geobenedict/Design-Files/CIRCUIT_DIAGRAM/PCB_FILES/RADIO_TRIANGULATION_BASE_STATION/RTK_PCB_Schematic.png

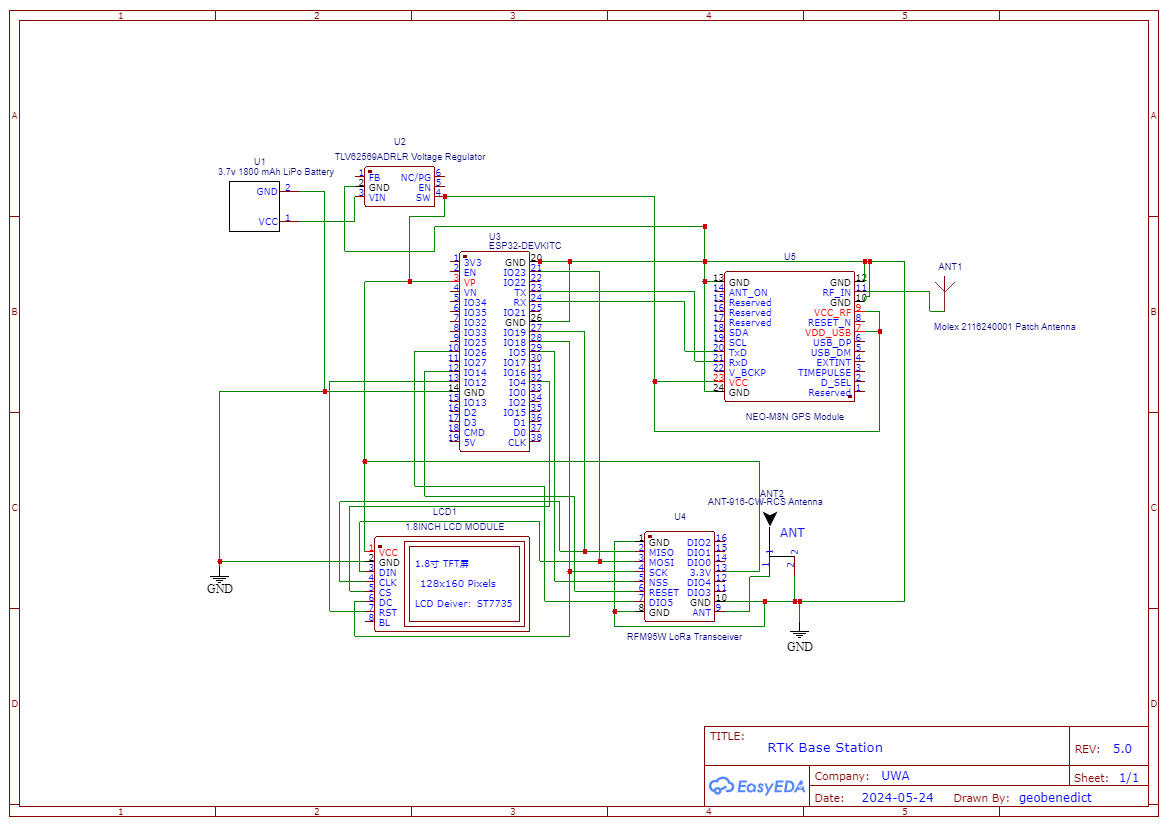
CIRCUIT_DIAGRAM/PCB_FILES/RADIO_TRIANGULATION_BASE_STATION/RTK_PCB_Schematic.png
