geobenedict/Design-Files/SYSTEM_DESIGN/Overall Design Architecture.jpg

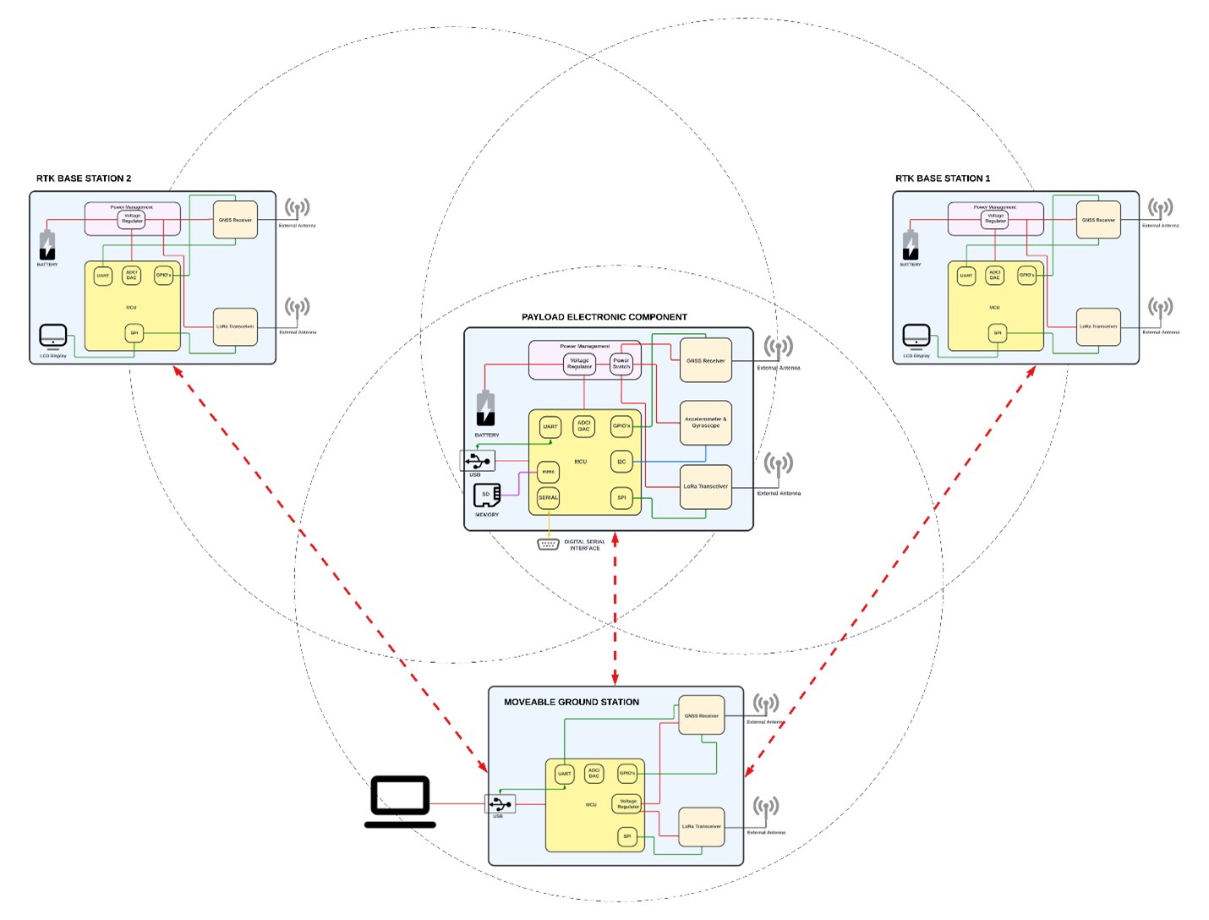
SYSTEM_DESIGN/Overall Design Architecture.jpg
