geobenedict/Design-Files/SYSTEM_DESIGN/Radio Triangulation Base Station Architecture.jpg

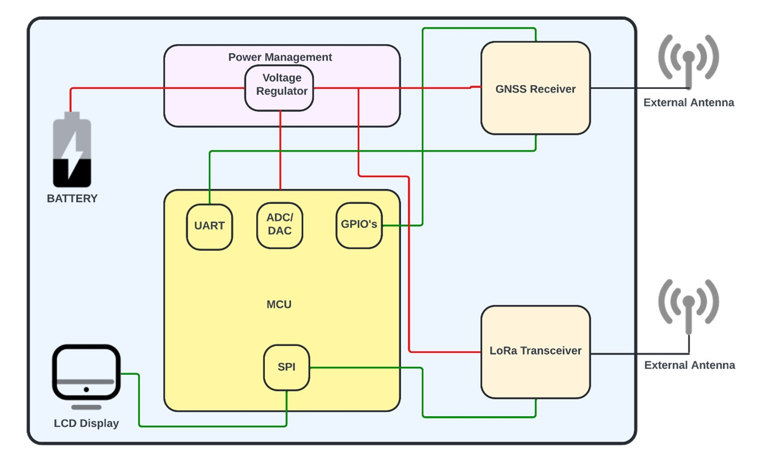
SYSTEM_DESIGN/Radio Triangulation Base Station Architecture.jpg
