geobenedict/Design-Files/SYSTEM_DESIGN/Receiving Bay Station Architecture.jpg

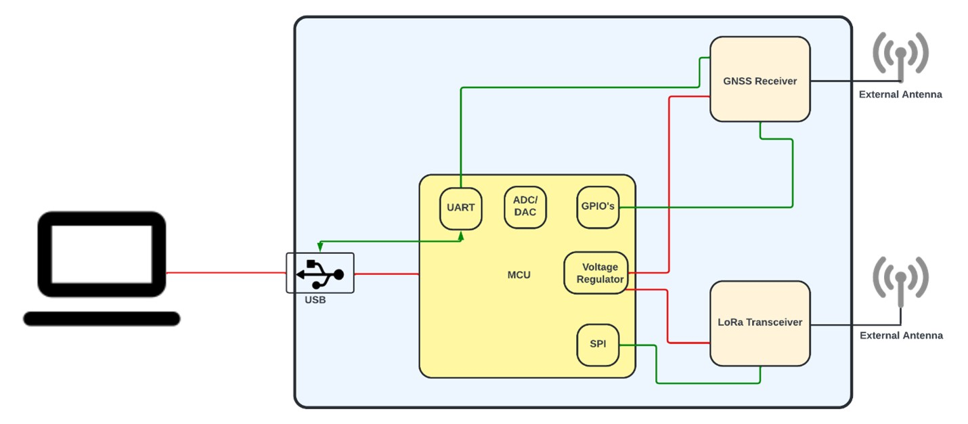
SYSTEM_DESIGN/Receiving Bay Station Architecture.jpg
