geobenedict/Design-Files/CIRCUIT_DIAGRAM/PCB_FILES/PAYLOAD_ELECTRIC_COMPONENT/DW_PEC_BOM_Weight_Power.xlsx

Sheet: BOM
Designator on Schematics | Description | Qty | Supplier | Supplier Unit Price (AUD) | Total Price
Components on the PCB
C1_SW2, C2_SW2, C_M2, C_S2, C_SW1 | CAP CER 0.1UF 50V X7R 0603 | 5 | Newark | 0.0303 | 0.1515
C _G1 | CAP CER 0.027UF 50V X7R 0805 | 1 | Arrow Electronics | 0.01636 | 0.01636
C_A1 | CAP CER 0.1UF 16V X7R 0402 | 1 | Newark | 0.00909 | 0.00909 |  | Power Consumption (mA)
C_M1 | Multilayer Ceramic Capacitors 22μF ±20% 10V X5R SMD 0805 | 1 | Newark | 0.18029 | 0.18029 |  | Component | ESP 32 WROOM 32 D | LoRa RFM95W | GPS NEO M8N | MPU 6050 | Voltage Regulator | Passive Components | Antenna
C_S1 | CAP CER 4.7UF 6.3V X5R 0603 | 1 | Mouser | 0.1818 | 0.1818 | Modes | Active Mode | 95 ~ 240 mA
C_U1 | CAP CER 0.1UF 200V 10% X7R 1206 | 1 | Newark | 0.10302 | 0.10302 |  | Modem Sleep Mode | 2~4 mA @ 2MHz 20~25mA @ 80MHz 30~ 50mA @240MHz
C_V1 | CAP CER 4.7UF 10V X5R 0402 | 1 | Newark | 0.13938 | 0.13938 |  | Light Sleep Mode | ~0.8 mA
C_V2, C_V3, C_V4 | CAP CER 10UF 6.3V X5R 0402 | 3 | Mouser | 0.22725 | 0.68175 |  | Deep Sleep Mode | 10 -150 uA
D1, D2, D3 | TVS DIODE 6V 10.3V DO214AA | 3 | Newark | 0.14847 | 0.44541 |  | Transmit Mode |  | RFOP = +20 dBm ~ 120mA RFOP = +17 dBm ~ 87mA RFOP = +13 dBm ~ 29mA RFOP = + 7 dBm ~ 20mA
J1 | Male Header, Pitch 2 mm, 1 x 2 Position, Height 5.5 mm, -25 to 85 degC, RoHS, Tape and Reel | 1 | Digikey | 0.61 | 0.61 |  | Receive Mode |  | 10.3mA
J2 | Micro-USB B Receptacle, Right Angle, Bottom Mount, Surface Mount, with Solder Tabs, -30 to 85 degC, 5-Pin USB, RoHS, Tape and Reel | 1 | Arrow Electronics | 0.56055 | 0.56055 |  | Sleep Mode |  | 0.2 ~ 1uA
J3 | CONN MICRO-D PLUG 9POS R/A SLDR | 1 | Arrow Electronics | 17.61 | 17.61 |  | Idle Mode |  | 1.5mA - RC oscillator enabled
J4 | CONN MICRO SD CARD PUSH-PULL R/A | 1 | Newark | 1.77 | 1.77 |  | Icc Acquisition |  |  | 25mA
L_G1 | Wire Wound RF Inductor 27nH ±2% 440mA 0.21Ω 0603 (1608) | 1 | Mouser | 0.22725 | 0.22725 |  | Icc Tracking - Continous mode |  |  | 23mA
L_V1 | Fixed Inductors 2.2uH Shld 20% 5.5A 38.7mOhms AECQ2 | 1 | Mouser | 3.58 | 3.58 |  | Icc Tracking - Power saving mode |  |  | 12mA
Q1, Q2 | NPN TRANSISTOR 1.5A 40V SOT-23 R | 2 | Digikey | 0.43935 | 0.8787 |  | Gyroscope + Accelerometer+DMP |  |  |  | 3.9mA
R 2 | RES 100K OHM 1% 1/16W 0402 | 1 | Newark | 0.00606 | 0.00606 |  | Gyroscope + Accelerometer |  |  |  | 3.8mA
R_G1 | RES | 1 | Arrow Electronics | 0.00773 | 0.00773 |  | Gyroscope Only |  |  |  | 500uA
R_S1 | RES | 1 | Newark | 0.00455 | 0.00455
R_S2, R_S4 | RES Thick Film, 100Ω, 5%, 0.1W, 200ppm/°C, 0603 | 2 | Digikey | 0.1515 | 0.303
R_S3 | RES SMD 47K OHM 5% 1/10W 0603 | 1 | Newark | 0.00455 | 0.00455
R_S5 |  | 1 | Newark | 0.00455 | 0.00455
R_S6, R_SW2 | RES Thick Film, 10kΩ, 5%, 0.125W, 200ppm/°C, 0805 | 2 | Digikey | 0.1515 | 0.303
R_S7, R_S8 | Chip Resistor, 0 Ohm, Jumper, +/- 5%, 0.125 W, -55 to 155 degC, 0805 (2012 Metric), RoHS, Tape and Reel | 2 | Mouser | 0.02424 | 0.04848
R_SH1, R_SH2 |  | 2 | Newark | 0.00303 | 0.00606
R_V1 | RES Thick Film, 453kΩ, 1%, 0.063W, 100ppm/°C, 0402 | 1 | Mouser | 0.1515 | 0.1515
SW1, SW2 | SWITCH TACTILE SPST-NO 0.05A 24V | 2 | Digikey | 0.68175 | 1.3635
U1 | WIFI MODULE 32MBITS SPI FLASH | 1 | Digikey | 7.21 | 7.21
U2 | RX TXRX MODULE ISM < 1GHZ SMD | 1 | Digikey | 21.88 | 21.88
U3 | U-Blox M8 Concurrent Gnss Module, 3.6 V, -40 to 85 degC, 24-Pin SMD, RoHS, Tape and Reel | 1 | Mouser | 47.72 | 47.72
U4 | 3-Axis Gyroscope, Accelerometer and a Digital Motion Processor(TM) (DMP), 2.375 to 3.46 V, -40 to 85 degC, 24-Pin QFN, RoHS, Tape and Reel | 1 | Digikey | 13.2 | 13.2
U5 | IC REG BUCK ADJ 2A SOT23-5 | 1 | Arrow Electronics | 0.64539 | 0.64539
U6 | IC BRIDGE USB TO UART 28QFN | 1 | Digikey | 7.46 | 7.46
UFL1, UFL2 | Ultra Small Coaxial Connector, 6 GHz, -40 to 90 degC, 3-Pin SMD, RoHS, Bulk | 2 | Newark | 1.31 | 2.62
Other Misc & connectors
B1 | BATTERY 3.7V 2000mAH | 1 | Core Electronics | 17.55 | 17.55
W1 | UFL TO SMA CONNECTOR | 2 | DigiKey | 5.99 | 11.98
A1 | HELICAL ANTENNA | 2
 |  |  |  | Total | 159.61347

Sheet: Weight
Components | Quantity | Weight | Total Weight
Capacitors | 14 | 0.0048 | 0.0672
Diodes | 3 | 0.093 | 0.279
Micro Usb | 1 | 0.233 | 0.233
Micro D | 1 | 4.47 | 4.47
Micro sd card | 1 | 0.026 | 0.026
Micro sd module | 1 | 0.05 | 0.05
Inductors | 2 | 0.003 | 0.006
Resistors | 14 | 0.05 | 0.7
Transistors | 2 | 0.05 | 0.1
Switches | 2 | 0.25 | 0.5
ESP32 | 1 | 2.3 | 2.3
RFM95W | 1 | 5 | 5
NEO M8N | 1 | 1.6 | 1.6
MPU6050 | 1 | 0.13 | 0.13
TLB | 1 | 0.01 | 0.01
CP2102 | 1 | 0.05 | 0.05
UFL Connector | 2 | 0.0157 | 0.0314
 |  | Total Weight | 15.5526
Battery | 1 | 40 | 40
 |  | Total Weight | 55.5526
Antenna | 2 | 15 | 30
 |  | Total Weight | 85.5526

Sheet: Power Consumption
 | Power Consumption (mA)
 | Component | ESP 32 WROOM 32 D | LoRa RFM95W | GPS NEO M8N | MPU 6050 | Voltage Regulator | Passive Components | Antenna
Modes | Active Mode | 95 ~ 240 mA
 | Modem Sleep Mode | 2~4 mA @ 2MHz 20~25mA @ 80MHz 30~ 50mA @240MHz
 | Light Sleep Mode | ~0.8 mA
 | Deep Sleep Mode | 10 -150 uA
 | Transmit Mode |  | RFOP = +20 dBm ~ 120mA RFOP = +17 dBm ~ 87mA RFOP = +13 dBm ~ 29mA RFOP = + 7 dBm ~ 20mA
 | Receive Mode |  | 10.3mA
 | Sleep Mode |  | 0.2 ~ 1uA
 | Idle Mode |  | 1.5mA - RC oscillator enabled
 | Icc Acquisition |  |  | 25mA
 | Icc Tracking - Continous mode |  |  | 23mA
 | Icc Tracking - Power saving mode |  |  | 12mA
 | Gyroscope + Accelerometer+DMP |  |  |  | 3.9mA
 | Gyroscope + Accelerometer |  |  |  | 3.8mA
 | Gyroscope Only |  |  |  | 500uA
