geobenedict/Design-Files/CIRCUIT_DIAGRAM/PCB_FILES/PAYLOAD_ELECTRIC_COMPONENT/OUTPUT_PCB_FILES/BOM/Bill of Materials-Final_PayloadPCB.xlsx

Comment | Description | Designator | Footprint | LibRef | Quantity
0.1uF | CAP CER 0.1UF 50V X7R 0603 | C1_SW2, C2_SW2, C_S2, C_SW1 | FP-C0603C-CF-MFG | CMP-2006-03061-2 | 4
27kPF | CAP CER 0.027UF 50V X7R 0805 | C _G1 | FP-C0805C-DN-MFG | CMP-1036-04122-3 | 1
0.1uF | CAP CER 0.1UF 16V X7R 0402 | C_A1 | FP-C0402-BB-MFG | CMP-2008-02108-2 | 1
22uF | Multilayer Ceramic Capacitors 22μF ±20% 10V X5R SMD 0805 | C_M1 | FP-C2012-125-0_2-MFG | CMP-08246-005813-1 | 1
O.1uF | CAP CER 0.1UF 50V X7R 0603 | C_M2 | FP-C0603C-CF-MFG | CMP-2006-03061-2 | 1
4.7uF | CAP CER 4.7UF 6.3V X5R 0603 | C_S1 | FP-C0603-CG-MFG | CMP-2006-02256-2 | 1
100nF | CAP CER 0.1UF 200V 10% X7R 1206 | C_U1 | FP-C1206C-EB-MFG | CMP-1037-04222-2 | 1
4.7uF | CAP CER 4.7UF 10V X5R 0402 | C_V1 | FP-C1005-050-0_15-MFG | CMP-2000-05997-2 | 1
10uF | CAP CER 10UF 6.3V X5R 0402 | C_V2, C_V3, C_V4 | FP-GRJ155-0_2-MFG | CMP-06035-062410-1 | 3
SMBJ6.0A | TVS DIODE 6V 10.3V DO214AA | D1, D2, D3 | FP-SMBJ-MFG | CMP-08607-000013-2 | 3
JST FEMALE HEADER | Male Header, Pitch 2 mm, 1 x 2 Position, Height 5.5 mm, -25 to 85 degC, RoHS, Tape and Reel | J1 | JST- S2B-PH-SM4-TB(LF)(SN)-2_V | CMP-1755-00001-1 | 1
105017-0001 | Micro-USB B Receptacle, Right Angle, Bottom Mount, Surface Mount, with Solder Tabs, -30 to 85 degC, 5-Pin USB, RoHS, Tape and Reel | J2 | USB-MICRO-B_V | CMP-2000-05827-1 | 1
83611-9006 | CONN MICRO-D PLUG 9POS R/A SLDR | J3 | FP-83611-9006-MFG | CMP-04774-000002-1 | 1
1140084168 | CONN MICRO SD CARD PUSH-PULL R/A | J4 | FP-1140084168-0 | CMP-02360-000003-1 | 1
27nH | Wire Wound RF Inductor 27nH ±2% 440mA 0.21Ω 0603 (1608) | L_G1 | FP-LQW18AN_00-MFG | CMP-06042-006496-1 | 1
2.2uH | Fixed Inductors 2.2uH Shld 20% 5.5A 38.7mOhms AECQ2 | L_V1 | FP-XAL4020-MFG | CMP-11268-000134-1 | 1
SS8050-G | NPN TRANSISTOR 1.5A 40V SOT-23 R | Q1, Q2 | FP-SS8050-G-MFG | CMP-20235-000001-1 | 2
100kOhm | RES 100K OHM 1% 1/16W 0402 | R 2 | FP-CRCW0402-C-e3-MFG | CMP-02407-010951-1 | 1
10Ohm |  | R_G1 | FP-ERJ1GN-MFG | CMP-2004-03448-2 | 1
22kOhm |  | R_S1 | RESC1608X55X30NL15T15 | CMP-1012-00106-2 | 1
100Ohm | RES Thick Film, 100Ω, 5%, 0.1W, 200ppm/°C, 0603 | R_S2, R_S4 | FP-CRCW0603-e3-IPC_B | CMP-2000-03827-2 | 2
47kOhm | RES SMD 47K OHM 5% 1/10W 0603 | R_S3 | FP-ERJ3G-IPC_B | CMP-1012-00114-3 | 1
20kOhm |  | R_S5 | FP-ERJ3G-MFG | CMP-2000-00741-2 | 1
10kOhm | RES Thick Film, 10kΩ, 5%, 0.125W, 200ppm/°C, 0805 | R_S6, R_SW2 | FP-CRCW0805-e3-IPC_C | CMP-2001-04910-2 | 2
0Ohm | Chip Resistor, 0 Ohm, Jumper, +/- 5%, 0.125 W, -55 to 155 degC, 0805 (2012 Metric), RoHS, Tape and Reel | R_S7, R_S8 | RESC2013X60X35ML10T20 | CMP-2100-03673-1 | 2
10kOhm |  | R_SH1, R_SH2 | RESC2013X70X40LL20T20 | CMP-2001-00337-1 | 2
453kOhm | RES Thick Film, 453kΩ, 1%, 0.063W, 100ppm/°C, 0402 | R_V1 | FP-CRCW0402-e3-MFG | CMP-2002-00012-2 | 1
B3F-6022 | SWITCH TACTILE SPST-NO 0.05A 24V | SW1, SW2 | FP-B3F-6022-MFG | CMP-08834-000012-1 | 2
ESP32-WROOM-32D | WIFI MODULE 32MBITS SPI FLASH | U1 | FP-ESP32-WROOM-32D-MFG | CMP-194065-000003-1 | 1
RFM95W-868S2 | RX TXRX MODULE ISM < 1GHZ SMD | U2 | FP-RFM95W-868S2-MFG | CMP-204316-000001-1 | 1
NEO-M8N-0 | U-Blox M8 Concurrent Gnss Module, 3.6 V, -40 to 85 degC, 24-Pin SMD, RoHS, Tape and Reel | U3 | UBX-NEO-M8-24_V | CMP-2000-07559-1 | 1
MPU-6050 | 3-Axis Gyroscope, Accelerometer and a Digital Motion Processor(TM) (DMP), 2.375 to 3.46 V, -40 to 85 degC, 24-Pin QFN, RoHS, Tape and Reel | U4 | IS-QFN-24_V | CMP-1753-00002-2 | 1
TLV62569DBVR | IC REG BUCK ADJ 2A SOT23-5 | U5 | FP-DBV0005A-MFG | CMP-04918-000387-1 | 1
CP2102N-A01-GQFN28 | IC BRIDGE USB TO UART 28QFN | U6 | FP-CP2102N-A01-GQFN28-MFG | CMP-08093-000004-1 | 1
U.FL-R-SMT-1(01) | Ultra Small Coaxial Connector, 6 GHz, -40 to 90 degC, 3-Pin SMD, RoHS, Bulk | UFL1 | HRS-U.FL-R-SMT-3_V | CMP-2000-05153-1 | 1
U.FL_GPS | Ultra Small Coaxial Connector, 6 GHz, -40 to 90 degC, 3-Pin SMD, RoHS, Bulk | UFL2 | HRS-U.FL-R-SMT-3_V | CMP-2000-05153-1 | 1
