geobenedict/Design-Files/TEAM07_DESIGN_VERIFICATION_AND_VALIDATION.xlsx

ID | Requirement description | Test | Passed | Learnings
RQ1 | Project Deliverables such as detailed report, final design architecture, schematics, complete PCB layout and outcome of the project | Review the detailed report to ensure it covers all agreed requirements, design documents, and test results Inspect the final design architecture diagrams/documents for completeness and clarity Check that complete schematics are provided for all circuits in the design Verify that the PCB layout files are complete, have all layers, and match the schematics Confirm that the project outcomes (design files, code, simulations etc.) are shared via a Git repository as specified | Yes | During the project execution phase, it became clear that the client expected to see the validation files as part of the deliverables.While the team was able to include the validation files in the Design Validation Section of the report, the requirement gathering could have been better understood and gathered during the initial stages of the project. The team report gives complete information on the design, justification for the component selection and explains how the design meets the requirements specified by the client. Simulation results are also provided where it is required. For validation files refer Design Validation Section of the report
RQ2 | The cost of the project should not exceed $1000. | Prepare a detailed bill of materials (BOM) listing all components required for the design Research and document the unit cost of each component from reputable suppliers, calculate the total cost by summing the costs of all components in the BOM Verify that the total cost is under the $1000 budget specified in the requirements. | Yes | Budget requirement of the project was clearly defined and understood by both the client (UWA Aviation Labs) and the project team. It specifies an explicit budget limit for the overall project cost. The requirement is traceable as it is listed under the "Deliverables for this project" section. The $1000 budget was tight for a project of this complexity, so cost optimization strategies were crucial. BOM preparation was started early in the design phase to identify high-cost components and to explore alternative lower-cost options if needed. A contingency budget was allocated for unexpected costs or component shortages. Expenses were regularly tracked against the budget, and the approach was adjusted if costs risked exceeding $1000. Refer Design Validation section for BOM.
RQ3 | Size of the PCB should not exceed 80*80mm so that it fits in 1U CubeSat | Measure the physical dimensions of the PCB layout, including any components or connectors that extend beyond the board edges Verify that the maximum length and width of the PCB layout, including any protrusions, does not exceed 80mm x 80mm | Yes | The client has explicitly specified the maximum allowable PCB size to ensure compatibility with the 1U CubeSat payload form factor. Utilized high-density layouts to minimize PCB area. A multi-layer PCB was designed to reduce the required board area. Adequate clearance is provided around the PCB edges for mounting holes or connectors.
RQ4 | Weight of the electronic component should not exceed 100 grams | Listing all components required for the design Research and document the weight of each component from manufacturer datasheets Calculate the total weight by summing the weights of all components in the BOM Verify that the total weight does not exceed 100 grams | Yes | The requirement for the tracking-telemetry system to not exceed 100 grams in weight was clearly communicated to the design team from the start. To meet this constraint, lightweight components and compact packages were prioritized throughout the design process. During the PCB layout phase, careful consideration was given to weight distribution and balance to ensure an even load across the board. The additional weight from connectors, cables, enclosures, and fasteners was also accounted for in the design. When the 100g limit was at risk of being exceeded, alternative lower-weight materials and optimized designs were explored, such as using high-density interconnect PCBs or replacing heavier components with lighter equivalents. For weight of system refer Design Validation section of the report.
RQ5 | The tracking telemetry system module must be self-powered to ensure prolonged operation. The system must remain powered for the entire mission, from launch through landing, until it is recovered. Specifically, the system should maintain continuous operation for 24 hours, encompassing all mission phases | Develop a detailed power consumption model for the tracking-telemetry system, accounting for all components and operational modes Calculate the expected power drawn over the 24-hour mission timeline, including launch, flight, descent, and landing phases. Select appropriate battery technology and capacity based on the simulated power requirements, with some safety margin Verify that the system remains fully operational throughout the 24-hour test period | Yes | The 24-hour continuous operation requirement was clearly communicated to the design team from the start. A detailed power consumption analysis was performed to guide the battery selection process. Low-power components were prioritized, and power management techniques were optimized to minimize battery drain. Battery chemistries with high energy density and discharge capabilities suitable for space applications were considered. Low-power modes or sleep states were implemented during periods of reduced activity to conserve battery life. For power consumption and dissipation calculations refer Design Validation section of the report.
RQ6 | The self-powered RF communication must be able to transmit data even if the rocket lands within 10km from the launch site. | Calculate test data packets from the telemetry system and verify Calculate the received signal strength, data integrity, and effective communication range under different test conditions | Yes | The 10km operational range requirement was clearly communicated to the design team from the start. An RF transceiver module with sufficient output power and sensitivity to achieve the required range was selected. The antenna design and placement were optimized for maximum radiation efficiency and coverage. Potential signal obstructions, multipath fading, and interference in the operational environment were accounted for. To extend the communication range, the use of a higher frequency band or directional antennas was considered.
RQ7 | The RF communication downlink should be capable to achieve the minimum data rate of 5kbits/sec | Review the specifications of the selected RF transceiver module to verify it supports a minimum data rate of 5kbits/sec or higher. Configure a test setup with the tracking-telemetry system transmitting simulated telemetry data packets at various data rates. Deploy receiver stations to capture the transmitted data and measure the effective downlink data throughput. Conduct the test under different conditions, including varying distances, signal obstructions, and potential interference sources. Record the minimum achievable downlink data rate and compare it against the 5kbits/sec requirement. | Yes | The minimum 5kbits/sec downlink data rate requirement was clearly communicated to the design team from the project brief provided by UWA Aviation Labs. A transceiver module with a higher maximum data rate capability was selected to accommodate the minimum 5kbits/sec requirement with sufficient margin. The modulation scheme, error correction coding, and framing protocols were optimized for efficient data transmission over the RF link. However we failed to identify and mitigate the potential sources of interference and signal degradation in the operational environment and were unable to configure a test setup. The antenna design and placement were optimized for maximum link quality and throughput to meet the specified data rate target. Adaptive data rate adjustment techniques were implemented to maintain the minimum 5kbits/sec throughput under varying link conditions. Sufficient margin was allocated in the data rate budget to accommodate future expansion or additional telemetry data streams from the payload sensors
RQ8 | The RF communication needs to be operated within unlicensed frequency to transmit the data to the base station. | Identify the unlicensed frequency bands available for use in the region where the rocket launch and tracking will take place. Select an RF transceiver module that operates within one of the identified unlicensed frequency bands. Configure the transceiver to transmit and receive on the chosen unlicensed frequency. Set up a test environment with the tracking-telemetry system transmitting data to a base station receiver. Verify that the data is successfully received at the base station without any interference or regulatory issues. Conduct the test under different conditions, such as varying distances, signal obstructions, and potential interference sources. | Yes | The local regulations and available unlicensed frequency bands for the region where the system would be operated were clearly understood. An RF transceiver module that supported operation within the 915 MHz ISM band, an identified unlicensed frequency band, was selected. It was ensured that the chosen 915 MHz ISM unlicensed frequency band provided sufficient range and data rate capabilities to meet the system's 5kbits/sec minimum downlink requirement. Any power output limitations or other restrictions imposed by the 915 MHz ISM band unlicensed frequency regulations were adhered to. Necessary certifications or approvals for the use of the 915 MHz unlicensed frequency band in the region of operation has to be obtained. We were unable to configure a test environment for the verification of results obtained.
RQ9 | Sensor’s data will be given via bidirectional serial port, 3.3V CMOS logic with 5V tolerance | Verify from the sensor datasheets that they communicate via a bidirectional serial port using 3.3V CMOS logic levels with 5V tolerance. Connect the sensor modules to the microcontroller or communication interface of the tracking-telemetry system. Configure the serial port on the microcontroller to operate at 3.3V CMOS logic levels. Implement level-shifting or voltage translation if required. Send test data from the sensors to the tracking-telemetry system via the serial port. | Yes | It was ensured that the microcontroller or communication interface supported 3.3V CMOS logic levels and could be configured for bidirectional serial communication.Appropriate serial communication protocols (UART) were used, and the baud rate, data format, and other parameters were configured as per the sensor requirements specified during TQ sessions. Sufficient memory and processing resources on the microcontroller were allocated to handle the data streams from the multiple payload sensors simultaneously, including the 5 temperature sensors, humidity sensor, altitude, speed, and GPS.
RQ10 | The payload location must be pinpointed accurately. To achieve this, GPS must provide the coordinates so the team can recover the payload. | Integrate a suitable GPS module into the tracking-telemetry system design. Configure the GPS module to provide NMEA data output containing latitude, longitude, and altitude coordinates. Connect the GPS module to the microcontroller or communication interface of the tracking-telemetry system. Implement software routines to parse and extract the coordinate data from the NMEA sentences received from the GPS module. | Yes | A GPS module with high sensitivity and accuracy, suitable for the expected operating conditions and altitude range of up to 4km for the rocket payload, was selected. It was ensured that the chosen GPS module could provide coordinate data in the standard NMEA format that could be easily parsed by the microcontroller. Error handling and data validation mechanisms were implemented to ensure reliable and accurate GPS coordinate data. Radio triangulation capabilities were implemented as a redundant or backup positioning method in case of GPS signal loss or degradation, per the requirement for redundancy.
RQ11 | The system must withstand the ambient temperature of 60°C | Perform thermal simulations and analysis to estimate the operating temperatures of the various components and subsystems within the tracking-telemetry payload under a 60°C ambient temperature condition. Identify components that may exceed their maximum rated operating temperatures and require additional cooling measures. Design and implement appropriate heat dissipation mechanisms, such as heat sinks, thermal interface materials, or active cooling solutions (e.g., fans, heat pipes). | Yes | The 60°C ambient temperature requirement was clearly communicated to the design team from the start. Components rated for extended operation at high temperatures, with temperature ranges exceeding 60°C, were selected. The use of specialized high-temperature materials, coatings, or encapsulants for components and PCBs was considered.The placement and spacing of high-power or heat-generating components on the PCB were optimized for better heat dissipation.
RQ12 | The system must withstand multiple flights hence the components lifecycle has to be carefully examined before selection. | Conduct thorough research on the lifecycle and reliability data of the components being considered for the tracking-telemetry system design. Obtain datasheets, application notes, and any available lifecycle testing reports from the component manufacturers. Identify the critical environmental factors that may affect component lifecycle, such as temperature, vibration, shock, and radiation exposure. Perform accelerated life testing or environmental stress screening on a sample of the selected components, simulating the expected conditions during multiple rocket flights. | Yes | We were unable to find the Australian standard for the consumer electronics. Basically, the electrical items last for 1 to 2 years, hence we confirm that the designed module will be capable to withstand multiple flights. Components with proven reliability and long operational lifetimes were prioritized for selection, especially for critical subsystems like the microcontroller, GPS, and RF communication modules. Industry standards such as MIL-STD-810, RoHS were consulted for guidance on component selection and testing for the harsh environments expected during the rocket launch and landing. For datasheets refer Design Validation section of the report.
RQ13 | Base stations must be designed to transmit and receive data. | Test the base station's ability to receive data by placing the tracking-telemetry payload in an operational setup and transmitting test data packets. Verify that the received data is correctly decoded and displayed or stored by the base station. Test the base station's transmit capability by sending commands or acknowledgments to the payload and verifying their reception. Conduct the tests under various conditions, such as varying distances, signal obstructions, and potential interference sources. | Yes | The base station receiver was designed with appropriate sensitivity, selectivity, and interference rejection capabilities to reliably receive the RF signal transmitted from the tracking-telemetry payload. Our base station consists of a micro, GPS, transceiver, and LCD display to display the data received. It was ensured that the base station transmitter complied with all relevant regulations and restrictions for the chosen 915 MHz ISM unlicensed frequency band and transmission power levels.
RQ14 | The telemetry system must be durable and able to withstand the forces and environmental factors the rocket will encounter during its launch, flight, and landing. It must be resilient enough to endure bumps, vibrations, extreme heat, and other challenging conditions. | Conduct vibration testing by subjecting to vibration profiles simulating the launch and descent phases of the rocket flight. Perform shock testing by dropping the system from various heights or using an impact testing machine to simulate the landing impact forces specified (around 8m/s). Conduct environmental testing, such as humidity, salt fog, or dust ingress tests, to ensure the system's resilience against various environmental factors it may encounter during the rocket's flight and landing. Perform electromagnetic interference (EMI) and electromagnetic compatibility (EMC) testing to verify the system's immunity to potential electromagnetic disturbances during the rocket's operation. | Yes | The environmental and durability requirements, including the expected 8m/s landing impact force, up to 60°C ambient temperature, and other conditions the system would encounter, were clearly communicated to the design team from the start. The system enclosure and internal component mounting were designed with ruggedness in mind, using materials and construction techniques that could withstand the specified shock, vibration, and temperature extremes during the rocket's launch, flight, and landing. Appropriate vibration isolation and shock absorption mechanisms, such as dampers, isolators, or potting compounds, could be implemented to protect sensitive components from the harsh vibrations and impact forces. Conformal coatings, gaskets, or hermetic sealing techniques were used to protect the system from moisture, dust, and other environmental contaminants it might encounter during the rocket's flight and landing. Components and materials rated for the expected temperature range of up to 60°C and other environmental conditions were selected, with sufficient design margins to ensure reliable operation.
RQ15 | Telemetry data to be transmitted through RF and the data is transmitted via serial communication | Integrate the serial communication interface (e.g., UART, SPI, I2C) between the microcontroller and the various sensors/payloads to acquire telemetry data.Implement data formatting and packetization routines to prepare the telemetry data for RF transmission. Configure the RF transmitter module to operate on the specified frequency band and modulation scheme. Set up a receiver station with an RF receiver module and a serial interface to a computer or data logger. | Yes | An RF transceiver module supporting the required data rates, modulation schemes, and the 915 MHz ISM frequency band was chosen for the telemetry transmission. It was ensured that the RF communication link operated within the specified 915 MHz ISM unlicensed frequency band and adhered to all relevant regulations and restrictions for unlicensed operation in that band.
RQ16 | The heat dissipation requirement is necessary for maintaining the system’s performance and reliability. As all the components generate heat during operation, the absence of a proper heat dissipation technique can lead to excessive heat build-up, affecting the performance and failure of the components. | Perform thermal simulations and analysis to estimate the heat generation and temperature rise of various components and subsystems under different operating conditions and power consumption levels. Identify components or subsystems that are prone to excessive heat build-up and require dedicated cooling measures. Design and implement appropriate heat dissipation techniques, such as heat sinks, thermal vias, airflow channels, or active cooling solutions (e.g., fans, heat pipes). | Yes | Detailed thermal simulations and analysis were conducted early in the design process to identify potential hot spots and thermal bottlenecks within the tracking-telemetry payload.Components with lower power consumption and heat generation characteristics were selected whenever possible to minimize the thermal load.Effective thermal management techniques, such as heat sinks, thermal vias, and airflow channels, were implemented in the PCB design.The thermal performance was tested under various operational scenarios, including worst-case power consumption and the specified 60°C ambient temperature condition. For heat map and dissipation calculations refer Design Validation section of the report.
RQ17 | The landing speed requirement of the telemetry system is for the system to withstand the landing speed of 8m/s. | Conduct detailed simulations and calculations to estimate the expected impact forces, shock loads, and deformation during the 8m/s landing. Design the system enclosure and internal component mounting with ruggedness in mind, using materials and construction techniques that can withstand the specified impact forces. Conduct thorough impact and shock testing early in the design process, using industry-standard test methods and specifications (e.g., MIL-STD-810, RTCA/DO-160). | Yes | The 8m/s landing speed requirement was clearly communicated to the design team from the start, as specified in the project brief. Components and materials that are rated for the expected shock and vibration levels, with sufficient design margins were selected. Optimized the placement and orientation of components within the enclosure to minimize the effects of impact forces and shock loads. Specialized shock-resistant mounting techniques or suspension systems can be used for sensitive components. The system enclosure and internal component mounting were designed with ruggedness in mind, using materials and construction techniques that could withstand the specified 8m/s landing impact forces.Appropriate shock absorption mechanisms, such as dampers, isolators, or potting compounds, were implemented to protect sensitive components from the impact loads during landing. For enclosure design refer Design Validation section of the report.
RQ18 | Telemetry monitoring and logging to collect and record data related to the satellite’s performance, status, and environmental conditions. | Implement data logging routines in the microcontroller or data processing unit to store the acquired telemetry data in non-volatile memory or a removable storage device. Configure the data logging routines to record the telemetry data at a specified sampling rate or interval. Implement time-stamping mechanisms to associate each telemetry data point with a precise time reference. | Yes | Appropriate data storage media, such as non-volatile memory or removable storage cards, with sufficient capacity and durability to store the expected volume of telemetry data throughout the rocket's mission, were selected. Efficient data compression or encoding techniques were implemented to optimize the storage space and transmission bandwidth requirements for the telemetry data. Data redundancy and error checking mechanisms, such as checksums or error-correcting codes, were implemented to ensure the integrity and reliability of the logged telemetry data.A user-friendly software application was developed for retrieving, analyzing, and visualizing the logged telemetry data after the rocket's recovery.
RQ19 | The product selected for the design needs to be safe and should not be a hazard to the environment, especially while selecting the battery. | Evaluate the energy density, discharge characteristics, and operating temperature range of the identified battery options to ensure they meet the system's power requirements and environmental conditions. Conduct safety testing on the selected battery type, including overcharge, overdischarge, short-circuit, and thermal abuse tests, to verify its safety under various fault conditions. Perform environmental impact assessments, such as toxicity tests, leakage tests, and disposal/recycling evaluations, to ensure the battery's compliance with relevant environmental regulations and standards. | Yes | The selection of battery chemistries with a proven track record of safety and minimal environmental impact, lithium-polymer (Li-Po) batteries, was prioritized. Battery technologies with known safety concerns or hazardous materials, such as lithium-ion batteries with cobalt-based cathodes or lead-acid batteries, were avoided. Robust battery management systems (BMS) with overcharge, overdischarge, short-circuit, and thermal protection mechanisms were implemented to ensure safe battery operation.The battery's end-of-life disposal and recycling requirements were considered, and options that could be easily and responsibly recycled or disposed of were selected. Relevant safety standards and regulations, such as IEC 62133 or UN 38.3, were consulted for guidance on battery safety testing and certification requirements. For datasheets refer Design Validation section of the report.
RQ20 | Redundancy in the microcontroller, communication and positioning is provided | Conduct the redundancy tests under various environmental conditions, such as temperature, vibration, and potential interference sources, to ensure reliable operation during the rocket's flight and landing. | Yes | The requirement for redundancy in the microcontroller, positioning, and communications was clearly stated in the project brief from UWA Aviation Labs. Multiple instances of critical subsystems, such as GPS receivers, and RF transceivers, were incorporated in the tracking-telemetry system design to implement redundancy. A redundancy management system was developed to continuously monitor the primary subsystems and automatically switch to the redundant subsystems in case of failure or degraded performance. The redundant subsystems were designed to be independent and isolated from each other to prevent a single point of failure from affecting the entire system.
