geobenedict/Design-Files/SYSTEM_DESIGN/Payload Electronic Component Architecture.jpg

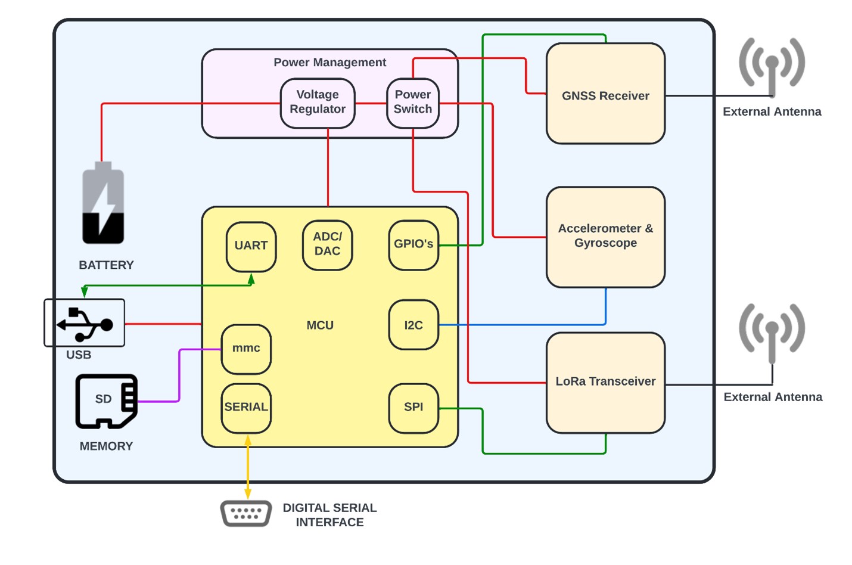
SYSTEM_DESIGN/Payload Electronic Component Architecture.jpg
