geobenedict/Design-Files/(list of files, cad)

Other CAD files:
CIRCUIT_DIAGRAM/PCB_FILES/PAYLOAD_ELECTRIC_COMPONENT/OUTPUT_PCB_FILES/AutoCAD PCB/Final_PayloadPCB.DWG
CIRCUIT_DIAGRAM/PCB_FILES/PAYLOAD_ELECTRIC_COMPONENT/OUTPUT_PCB_FILES/AutoCAD SCH/Sheet1.dwg
