geobenedict/Design-Files/CIRCUIT_DIAGRAM/DW_VR_WBDesign11.pdf

## WEBENCH ® Design Report

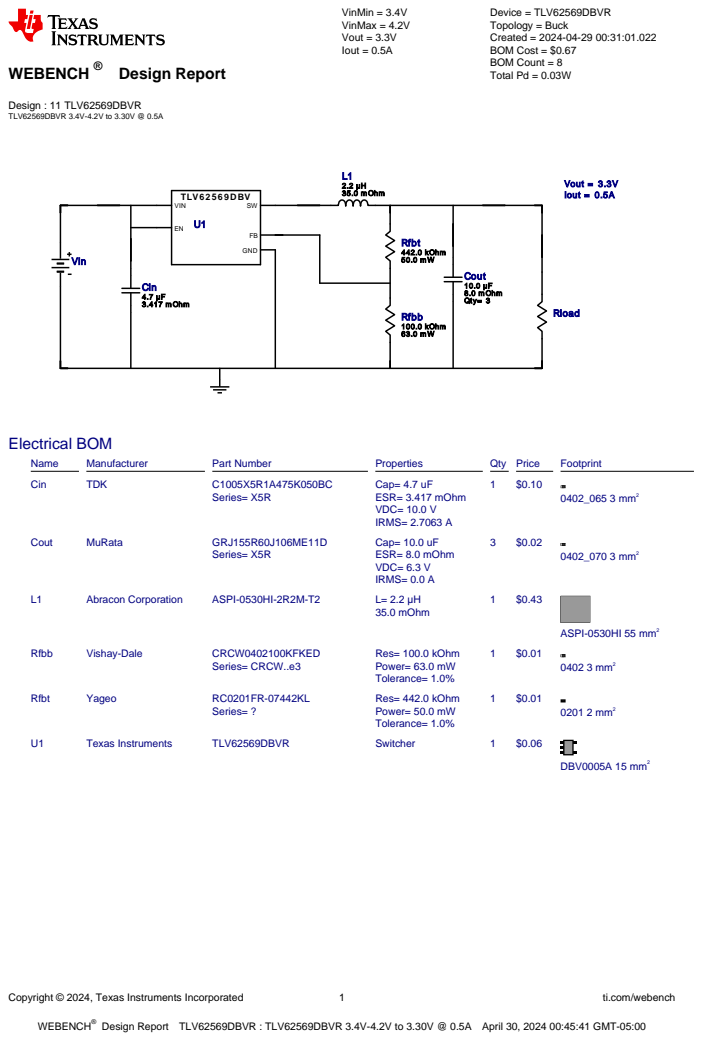
[picture p12: page 1]
Copyright © 2024, Texas Instruments Incorporated; ti.com/webench; WEBENCH®; Design : 11 TLV62569DBVR TLV62569DBVR 3.4V-4.2V to 3.30V @ 0.5A; VinMin = 3.4V VinMax = 4.2V Vout = 3.3V Iout = 0.5A; Device = TLV62569DBVR Topology = Buck Created = 2024-04-29 00:31:01.022 BOM Cost = $0.67 BOM Count = 8 Total Pd = 0.03W; Cin 4.7 µF 3.417 m Ohm; Cout 10.0 µF 8.0 m Ohm Qty= 3; L1 2.2 µH 35.0 m Ohm TLV6 2 5 6 9 DBV; GND; VIN; Vout = 3.3V Iout = 0.5A; Rfbt 442.0 kOhm 50.0 m W; Rfbb 100.0 kOhm 63.0 m W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

Design Report TLV62569DBVR : TLV62569DBVR 3.4V-4.2V to 3.30V @ 0.5A April 30, 2024 00:45:41 GMT-05:00

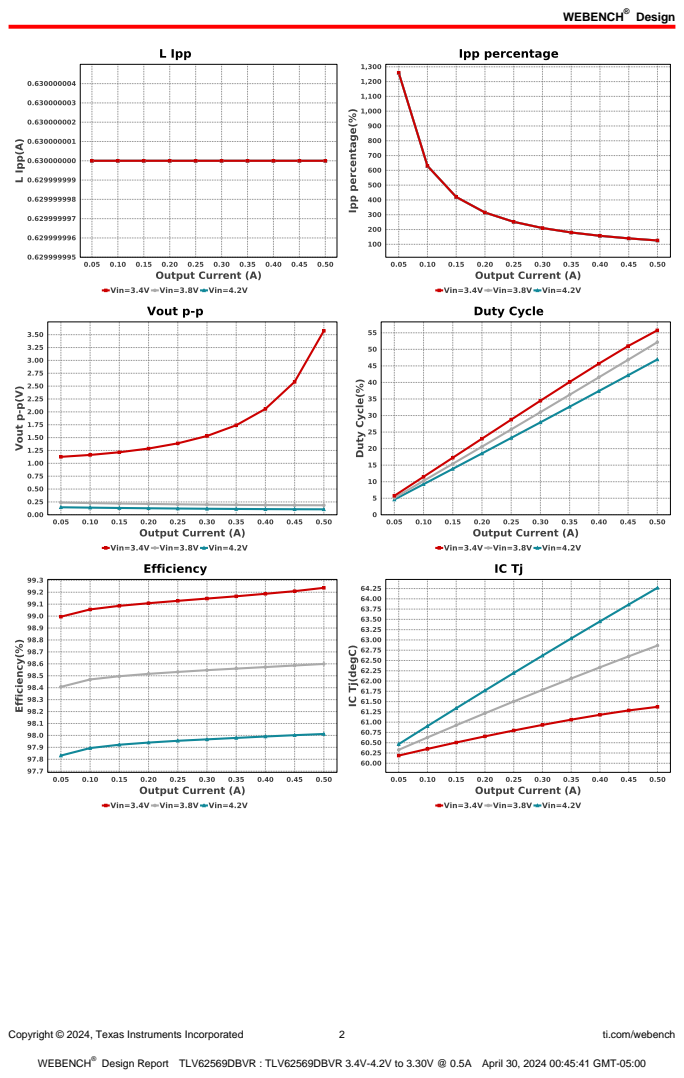
[picture p13: page 2]
Design; Copyright © 2024, Texas Instruments Incorporated; ti.com/webench

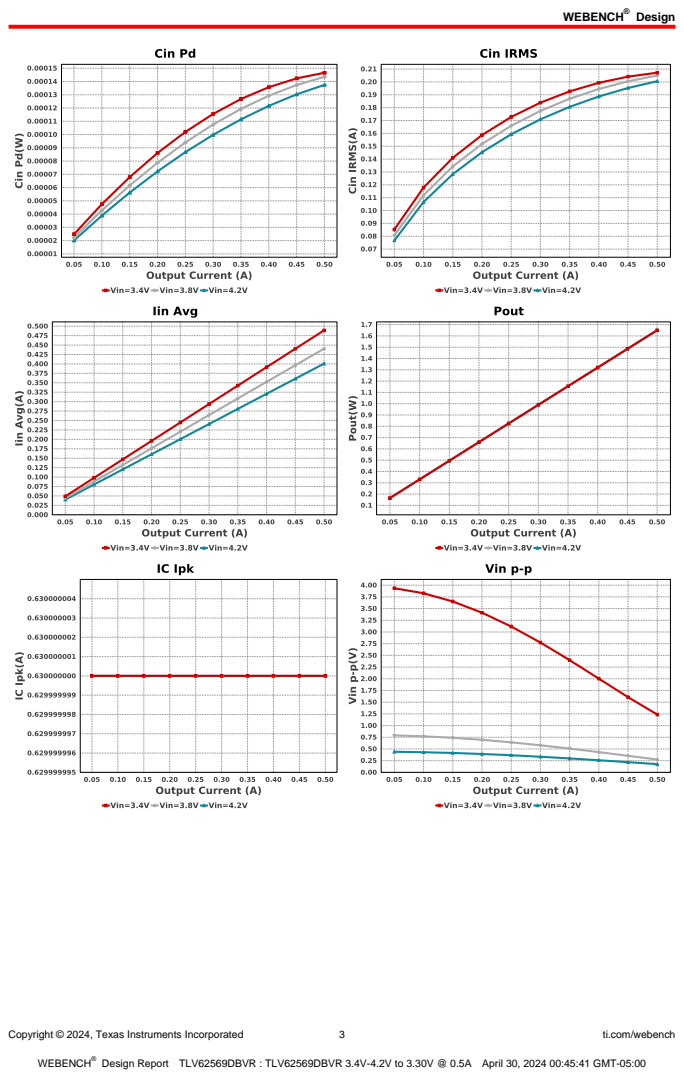
[picture p14: page 3]
Copyright © 2024, Texas Instruments Incorporated; ti.com/webench

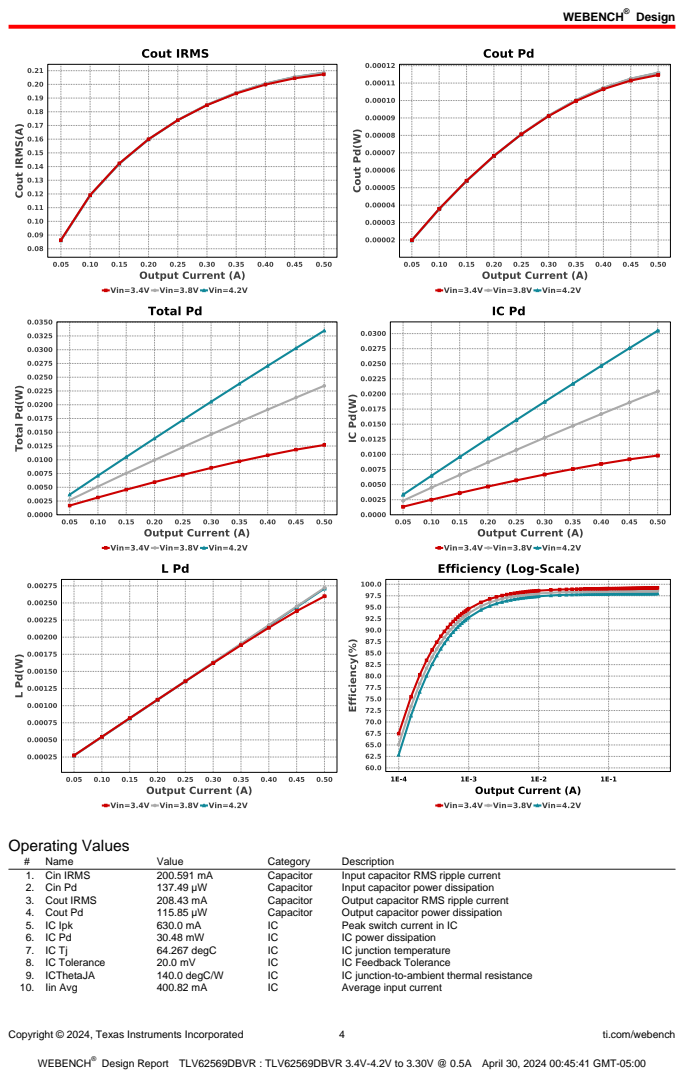
[picture p15: page 4]
Copyright © 2024, Texas Instruments Incorporated; ti.com/webench; Operating Values; Name; Value; Category; Description; 1. Cin IRMS; Capacitor; Input capacitor RMS ripple current; 2. Cin Pd; Input capacitor power dissipation; 3. Cout IRMS; Output capacitor RMS ripple current; 4. Cout Pd; Output capacitor power dissipation; 5. IC Ipk; Peak switch current in IC; IC power dissipation; 64.267 degC; IC junction temperature; 8. IC Tolerance; IC Feedback Tolerance; 9. ICThetaJA; 140.0 degC/W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

Copyright © 2024, Texas Instruments Incorporated | 5 | ti.com/webench
# | Name | Value | Category | Description

11. Ipp percentage | 126.0 % | Inductor | Inductor ripple current percentage (with respect to average inductor
| | | | current)
12. L Ipp | 630.0 mA | Inductor | Peak-to-peak inductor ripple current
13. L Pd | 2.71 mW | Inductor | Inductor power dissipation
14. Cin Pd | 137.49 µW | Power | Input capacitor power dissipation
15. Cout Pd | 115.85 µW | Power | Output capacitor power dissipation
16. IC Pd | 30.48 mW | Power | IC power dissipation
17. L Pd | 2.71 mW | Power | Inductor power dissipation
18. Total Pd | 33.467 mW | Power | Total Power Dissipation
19. BOM Count | 8 | System
| | | Information | Total Design BOM count
20. Duty Cycle | 46.935 % | System
| | | Information | Duty cycle
21. Efficiency | 98.012 % | System
| | | Information | Steady state efficiency
22. FootPrint | 87.0 mm² | System
| | | Information | Total Foot Print Area of BOM components
23. Frequency | 280.043 kHz | System
| | | Information | Switching frequency
24. Iout | 500.0 mA | System
| | | Information | Iout operating point
25. Mode | PFM | System
| | | Information | Conduction Mode
26. Pout | 1.65 W | System
| | | Information | Total output power
27. Total BOM | $0.666 | System
| | | Information | Total BOM Cost
28. Vin | 4.2 V | System
| | | Information | Vin operating point
29. Vin p-p | 175.8 mV | System
| | | Information | Peak-to-peak input voltage
30. Vout | 3.3 V | System
| | | Information | Operational Output Voltage
31. Vout Actual | 3.252 V | System
| | | Information | Vout Actual calculated based on selected voltage divider resistors
32. Vout Tolerance | 5.036 % | System
| | | Information | Vout Tolerance based on IC Tolerance (no load) and voltage divider resistors if applicable
33. Vout p-p | 106.689 mV | System
| | | Information | Peak-to-peak output ripple voltage

## Design Inputs

Name | Value | Description
| Iout | | 500.0 m | Maximum Output Current
VinMax | 4.2 | Maximum input voltage
VinMin | 3.4 | Minimum input voltage
VinTyp | 3.7 | Typical input voltage
Vout | 3.3 | Output Voltage
| base_pn | | TLV62569 | Base Product Number
source | DC | Input Source Type
Ta | 60.0 | Ambient temperature


Copyright © 2024, Texas Instruments Incorporated | 6 | ti.com/webench

## Assembly

## Component Testing

Some published data on components in datasheets such as Capacitor ESR and Inductor DC resistance is based on conservative values that will guarantee that the components always exceed the specification. For design purposes it is usually better to work with typical values. Since this data is not always available it is a good practice to measure the Capacitance and ESR values of Cin and Cout, and the inductance and DC resistance of L1 before assembly of the board. Any large discrepancies in values should be electrically simulated in WEBENCH to check for instabilities and thermally simulated in WebTHERM to make sure critical temperatures are not exceeded.

## Soldering Component to Board

If board assembly is done in house it is best to tack down one terminal of a component on the board then solder the other terminal. For surface mount parts with large tabs, such as the DPAK, the tab on the back of the package should be pre-tinned with solder, then tacked into place by one of the pins. To solder the tab town to the board place the iron down on the board while resting against the tab, heating both surfaces simultaneously. Apply light pressure to the top of the plastic case until the solder flows around the part and the part is flush with the PCB. If the solder is not flowing around the board you may need a higher wattage iron (generally 25W to 30W is enough).

## Initial Startup of Circuit

It is best to initially power up the board by setting the input supply voltage to the lowest operating input voltage 3.4V and set the input supply's current limit to zero. With the input supply off connect up the input supply to Vin and GND. Connect a digital volt meter and a load if needed to set the minimum Iout of the design from Vout and GND. Turn on the input supply and slowly turn up the current limit on the input supply. If the voltage starts to rise on the input supply continue increasing the input supply current limit while watching the output voltage. If the current increases on the input supply, but the voltage remains near zero, then there may be a short or a component misplaced on the board. Power down the board and visually inspect for solder bridges and recheck the diode and capacitor polarities. Once the power supply circuit is operational then more extensive testing may include full load testing, transient load and line tests to compare with simulation results.

## Load Testing

The setup is the same as the initial startup, except that an additional digital voltmeter is connected between Vin and GND, a load is connected between Vout and GND and a current meter is connected in series between Vout and the load. The load must be able to handle at least rated output power + 50% ( 7.5 watts for this design). Ideally the load is supplied in the form of a variable load test unit. It can also be done in the form of suitably large power resistors. When using an oscilloscope to measure waveforms on the prototype board, the ground leads of the oscilloscope probes should be as short as possible and the area of the loop formed by the ground lead should be kept to a minimum. This will help reduce ground lead inductance and eliminate EMI noise that is not actually present in the circuit.

## Design Assistance

1. Feature Highlights: Constant Average Current, up to 2A, 2.5 V to 5.5 V Input Voltage Range, Integrated Thermal ProtectionIdeal for portable applications
2. Master key : F605FA9BD9E0EE3D116394182D180243[v1]
3. TLV62569 Product Folder : http://www.ti.com/product/TLV62569 : contains the data sheet and other resources.

Copyright © 2024, Texas Instruments Incorporated | 7 | ti.com/webench

Important Notice and Disclaimer

TI provides technical and reliability data (including datasheets), design resources (including reference designs), application or other design advice, web tools, safety information, and other resources AS IS and with all faults, and disclaims all warranties. These resources are intended for skilled developers designing with TI products. You are solely responsible for (1) selecting the appropriate TI products for your application, (2) designing, validating and testing your application, and (3) ensuring your application meets applicable standards, and any other safety, security, or other requirements.

These resources are subject to change without notice. TI grants you permission to use these resources only for development of an application that uses the TI products described in the resource. Other reproduction and display of these resources is prohibited. No license is granted to any other TI intellectual property right or to any third party intellectual property right. TI disclaims responsibility for, and you will fully indemnify TI and its representatives against, any claims, damages, costs, losses, and liabilities arising out of your use of these resources.

Providing these resources does not expand or otherwise alter TI's applicable Terms of Sale or other applicable terms available either on ti.com or provided in conjunction with TI products.
