geobenedict/Design-Files/CIRCUIT_DIAGRAM/PCB_FILES/PAYLOAD_ELECTRIC_COMPONENT/DW_PEC_BOARD_STACK_REPORT.PDF

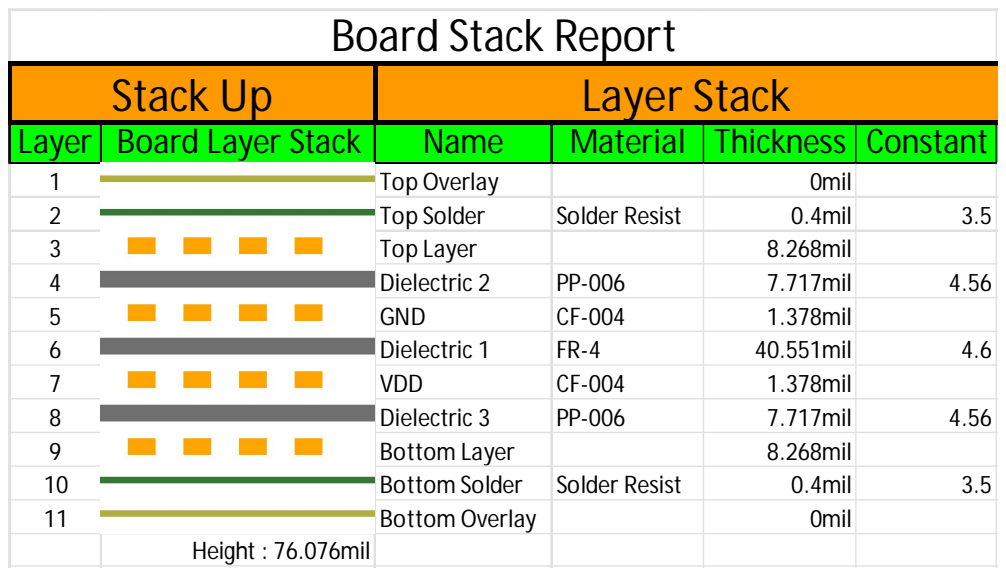
[picture p17: page 1]

Stack Up | Layer Stack
Layer | Board Layer Stack | Name | Material | Thickness | Constant
1 | | Top Overlay | | 0mil
2 | | Top Solder | Solder Resist | 0.4mil | 3.5
3 | | Top Layer | | 8.268mil
4 | | Dielectric 2 | PP-006 | 7.717mil | 4.56
5 | | GND | CF-004 | 1.378mil
6 | | Dielectric 1 | FR-4 | 40.551mil | 4.6
7 | | VDD | CF-004 | 1.378mil
8 | | Dielectric 3 | PP-006 | 7.717mil | 4.56
9 | | Bottom Layer | | 8.268mil
10 | | Bottom Solder | Solder Resist | 0.4mil | 3.5
11 | | Bottom Overlay | | 0mil

Height : 76.076mil
