geobenedict/Design-Files/CIRCUIT_DIAGRAM/PCB_FILES/PAYLOAD_ELECTRIC_COMPONENT/DW_PEC_DRAFTSMAN_SCHEMATICS.PDF

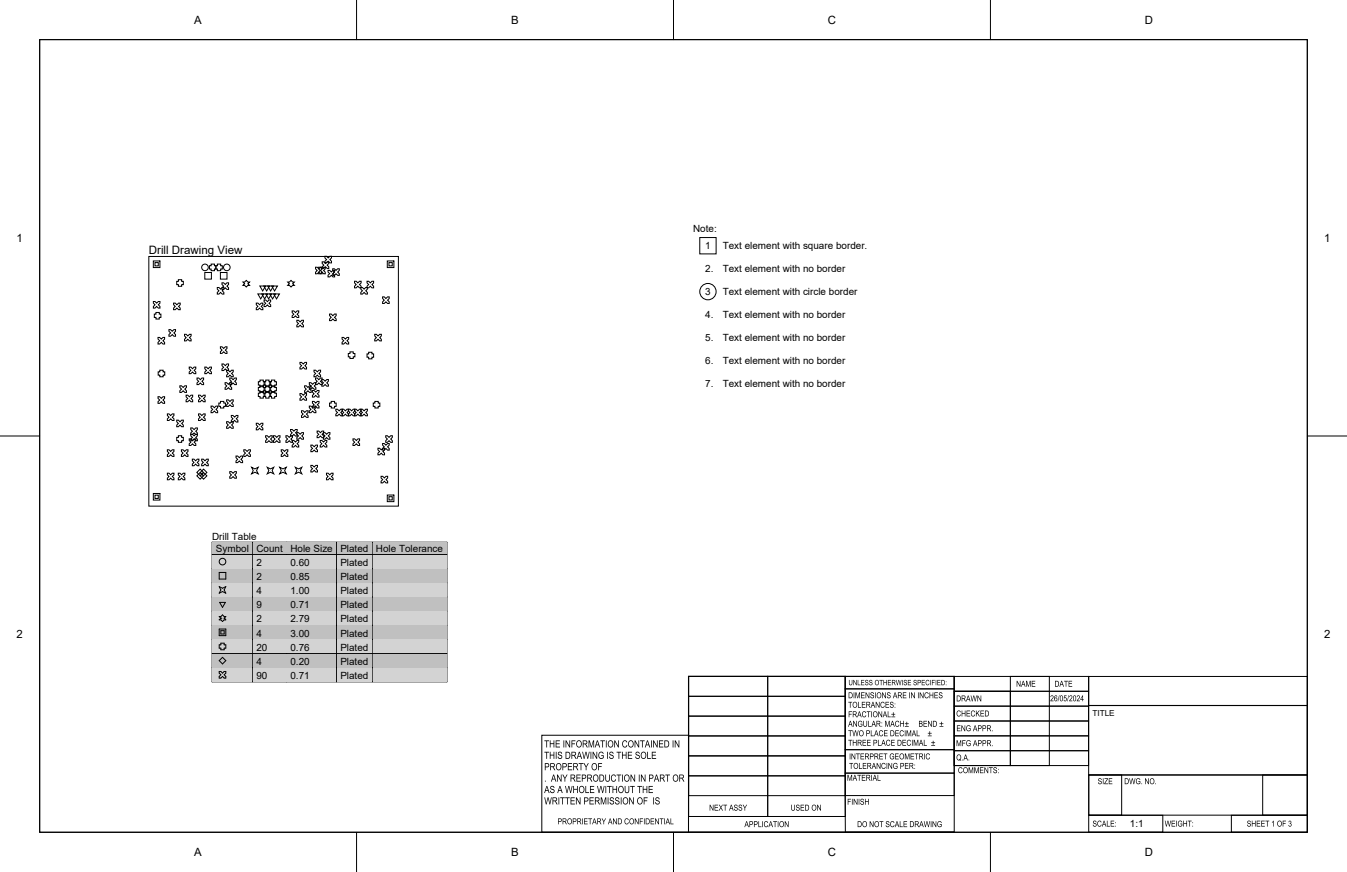
[picture p18: page 1]

2. Text element with no border

3 Text element with circle border

4. Text element with no border

5. Text element with no border

6. Text element with no border

7. Text element with no border

Symbol | Count | Hole Size | Plated | Hole Tolerance

2 | 0.60 | Plated
2 | 0.85 | Plated
4 | 1.00 | Plated
9 | 0.71 | Plated
2 | 2.79 | Plated
4 | 3.00 | Plated
20 | 0.76 | Plated
4 | 0.20 | Plated
90 | 0.71 | Plated

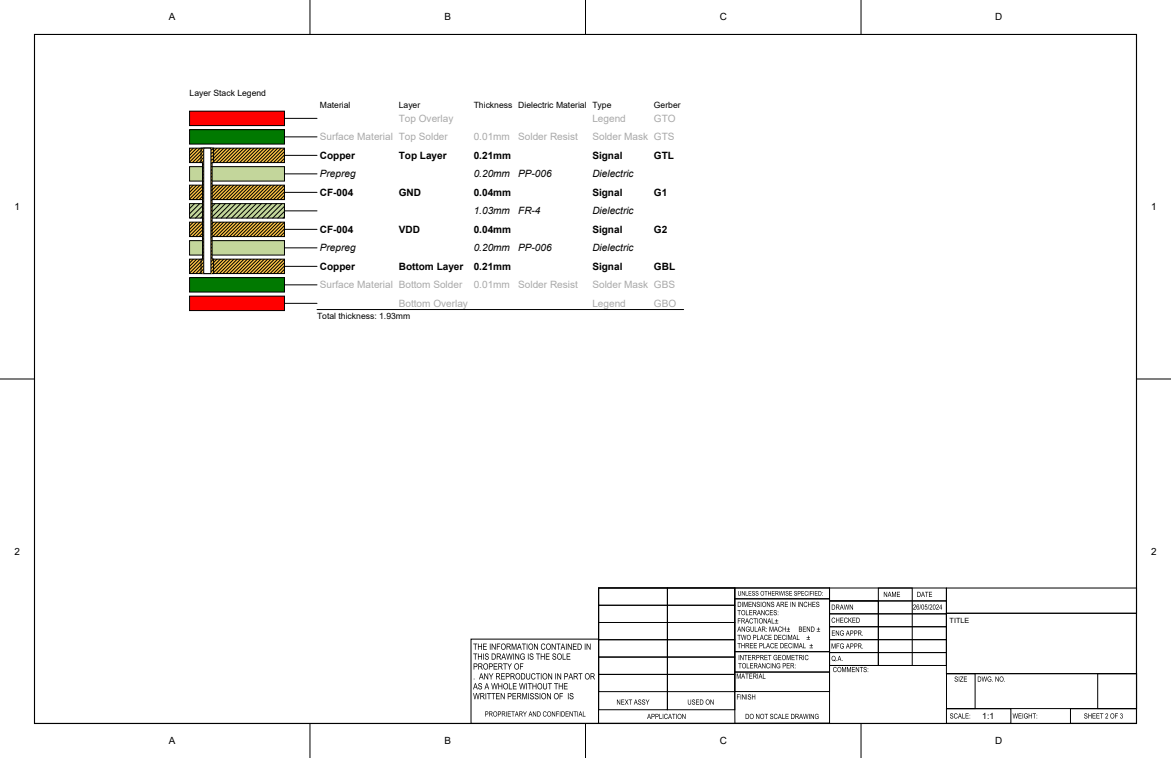
[picture p19: page 2]

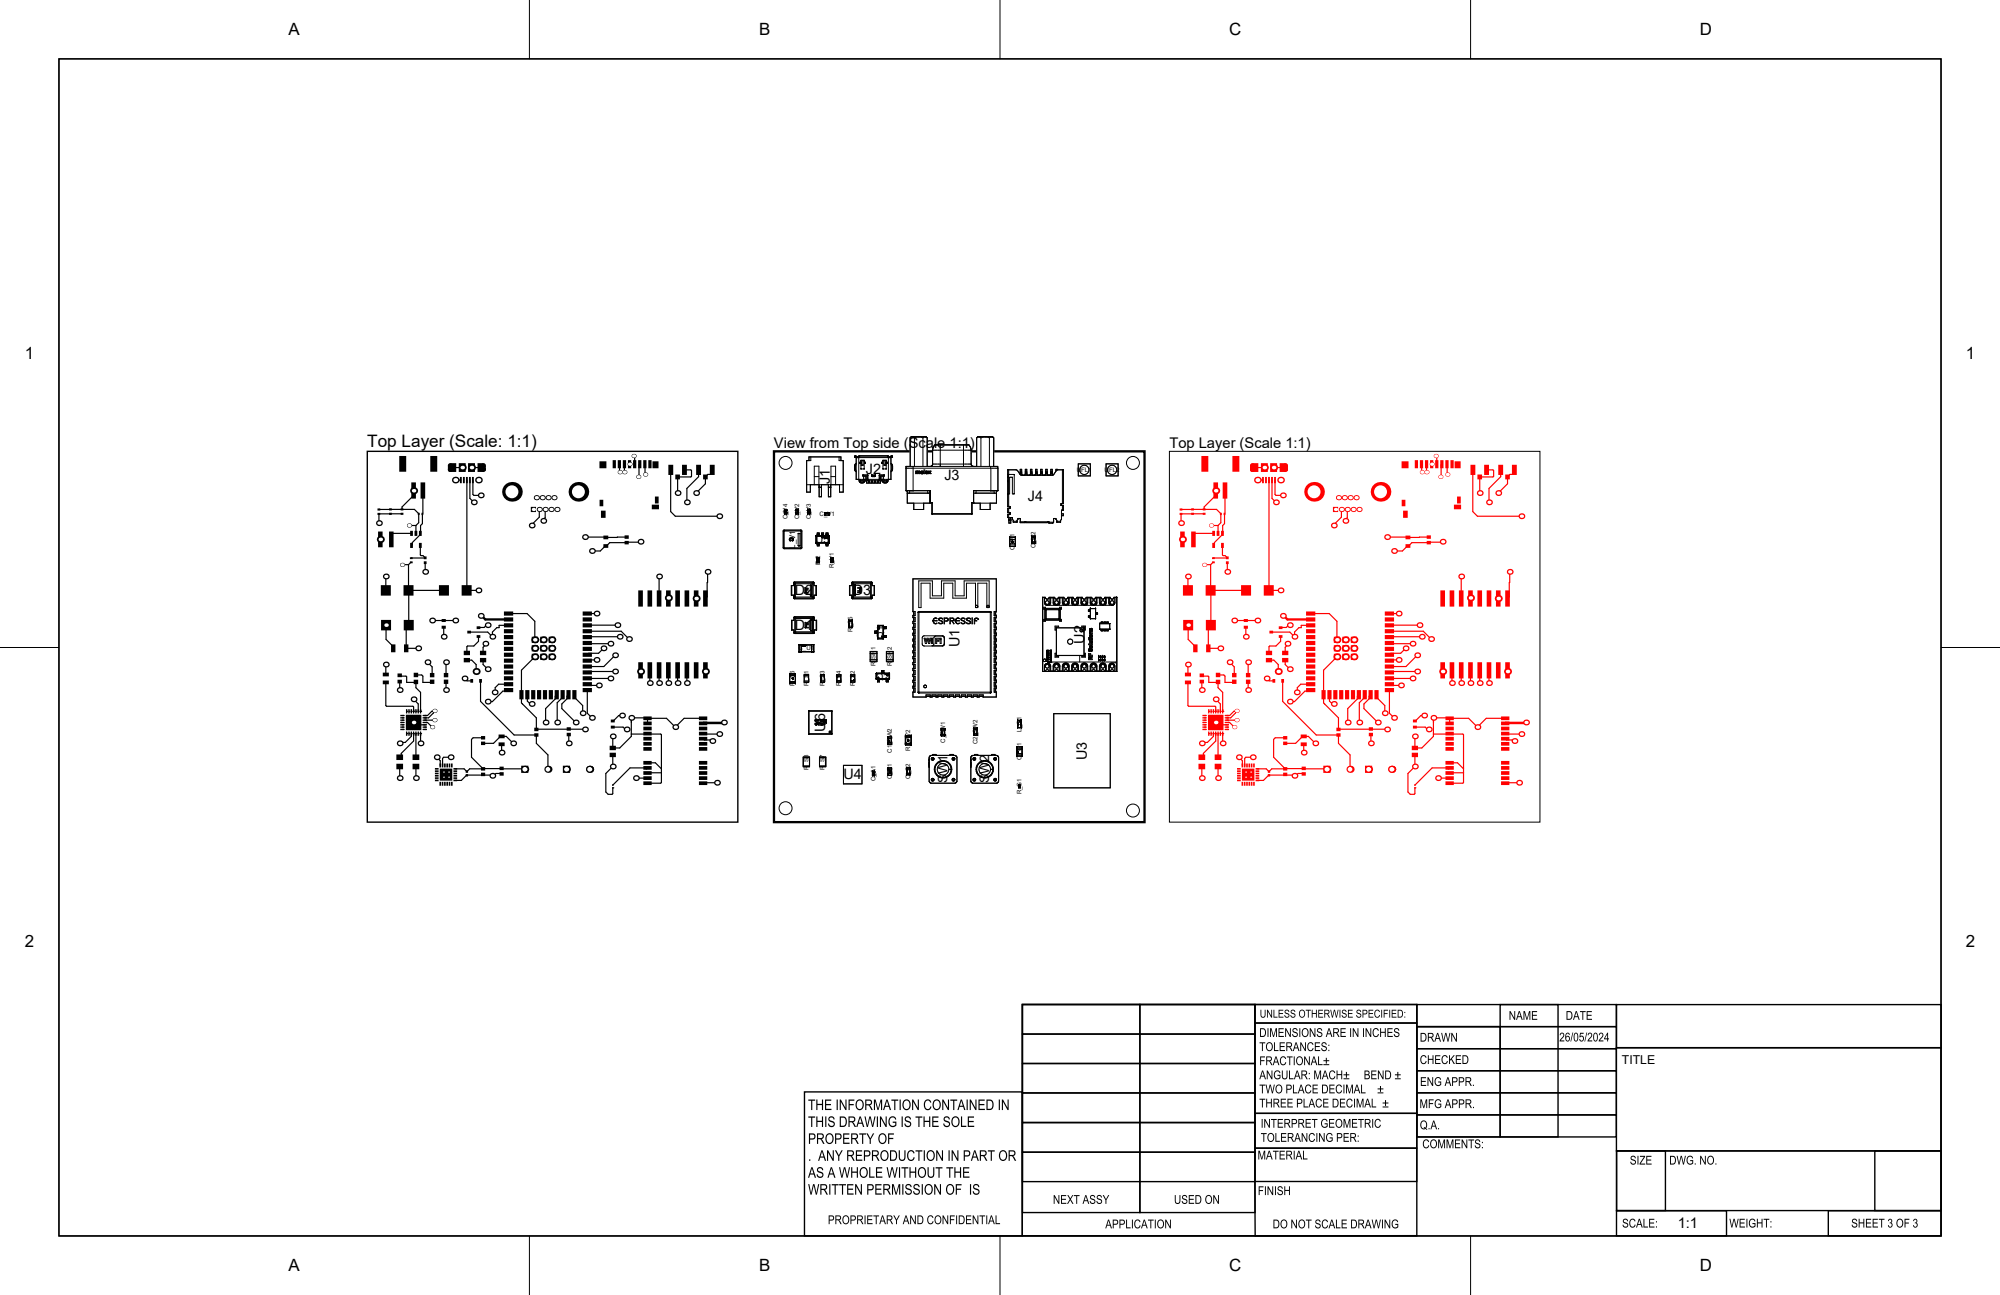
[picture p20: page 3]
