geobenedict/Design-Files/CIRCUIT_DIAGRAM/PCB_FILES/PAYLOAD_ELECTRIC_COMPONENT/DW_ASSEMBLY_DRAWINGS.PDF

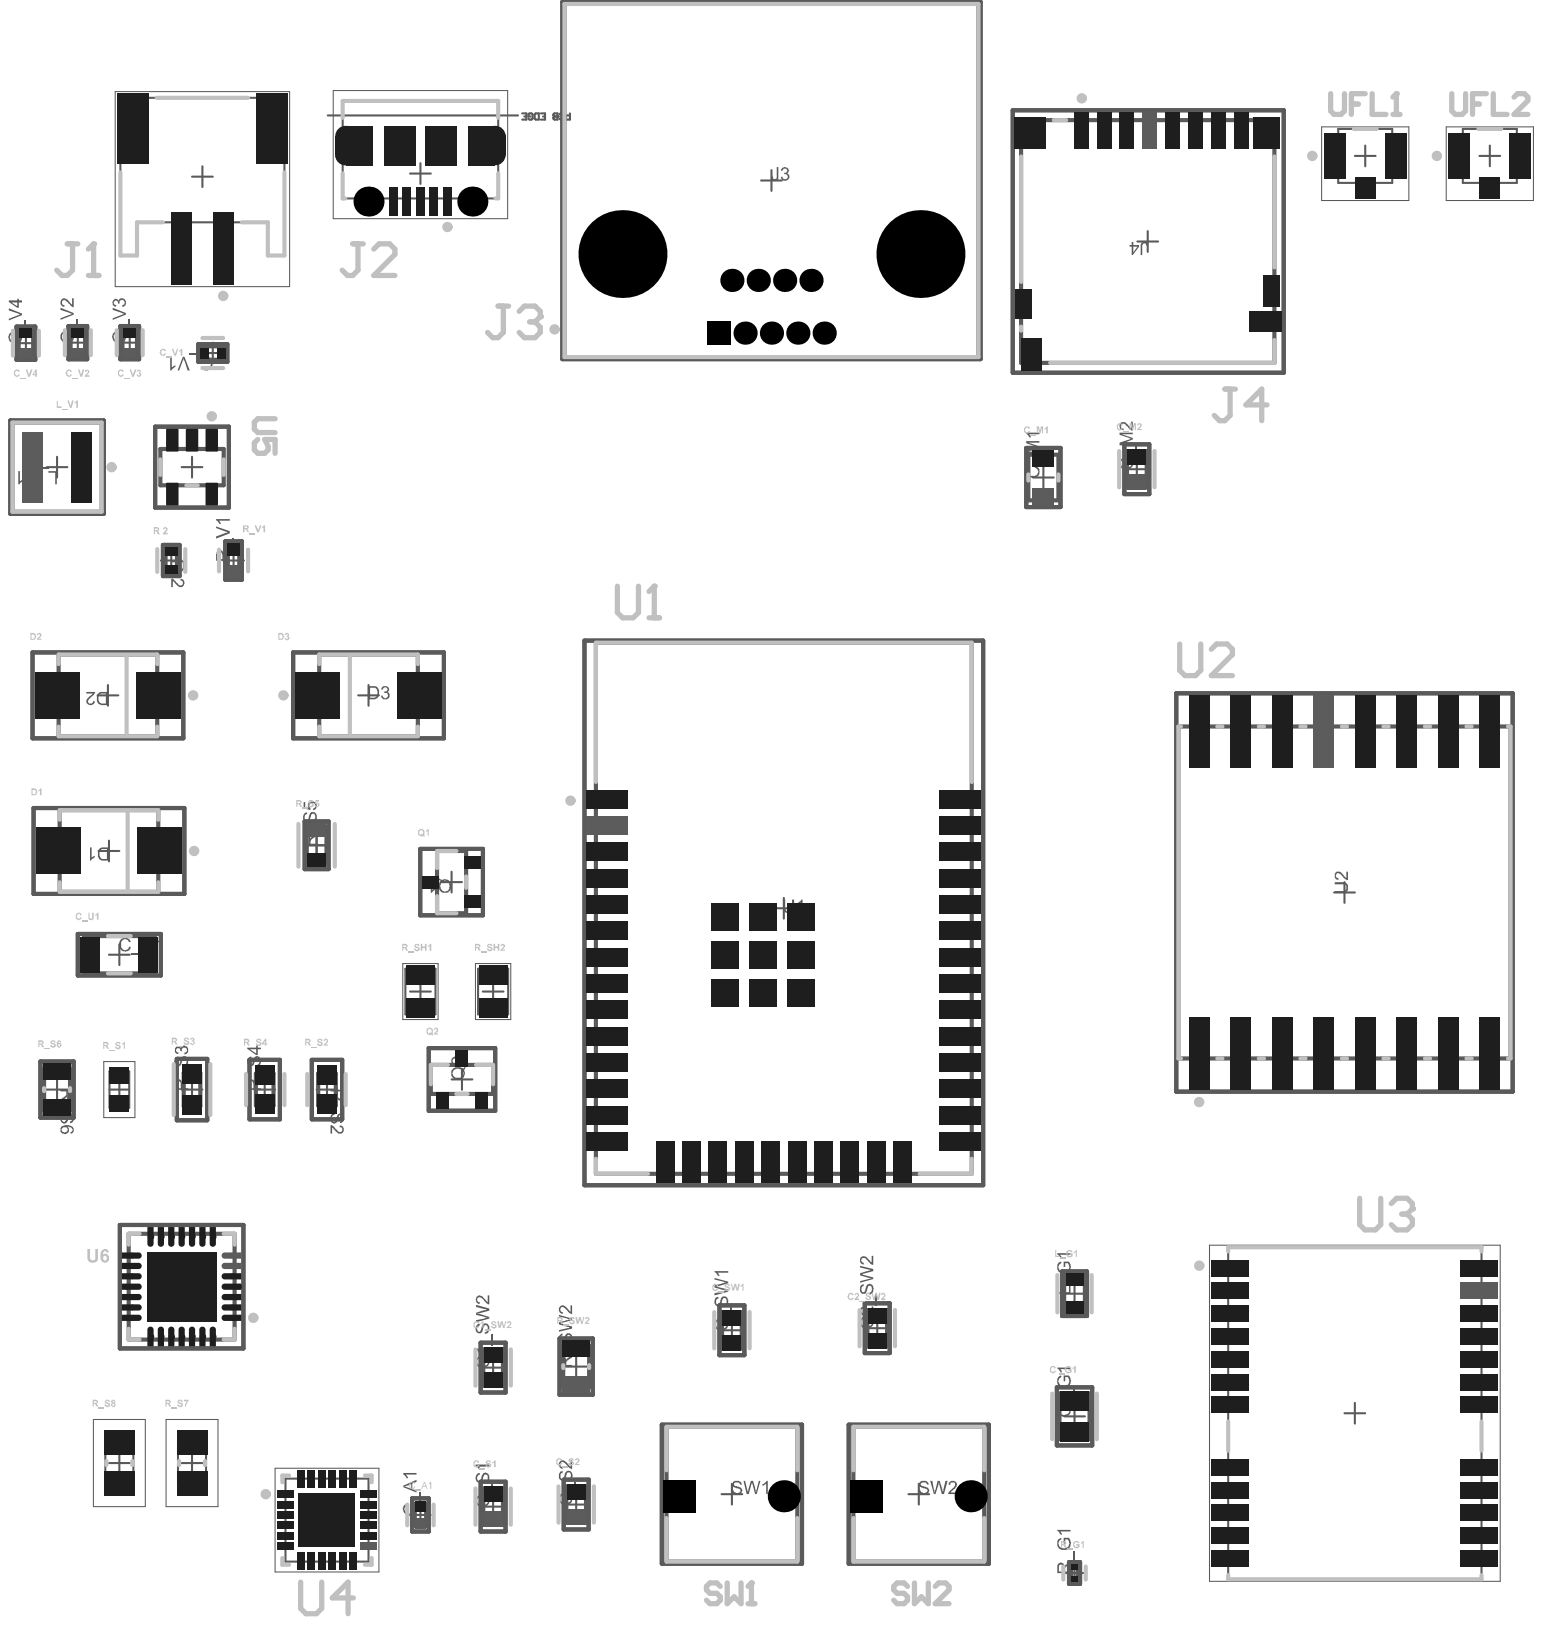
[picture p21: page 1]

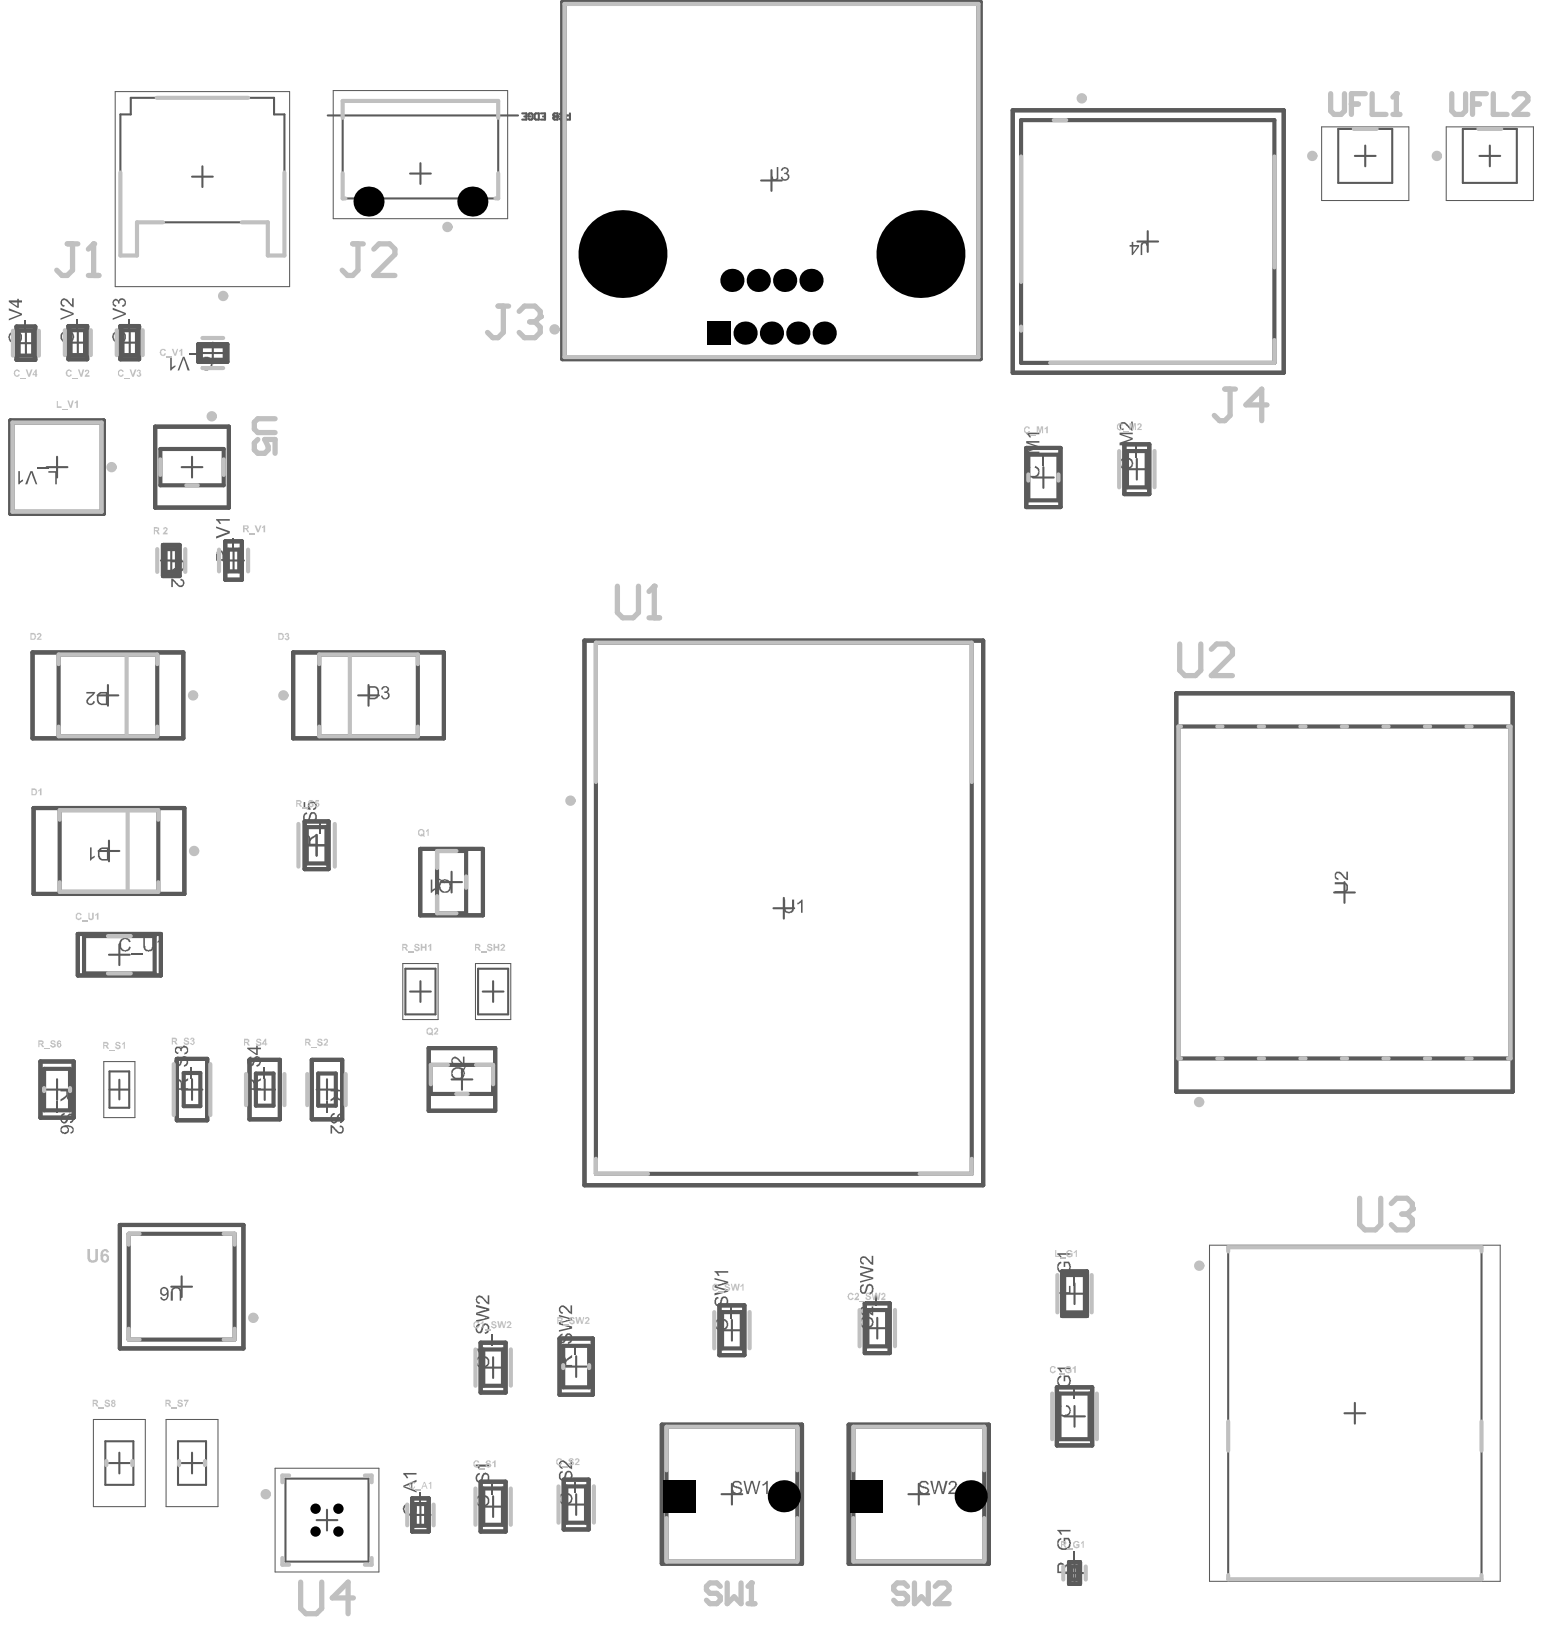
[picture p22: page 2]

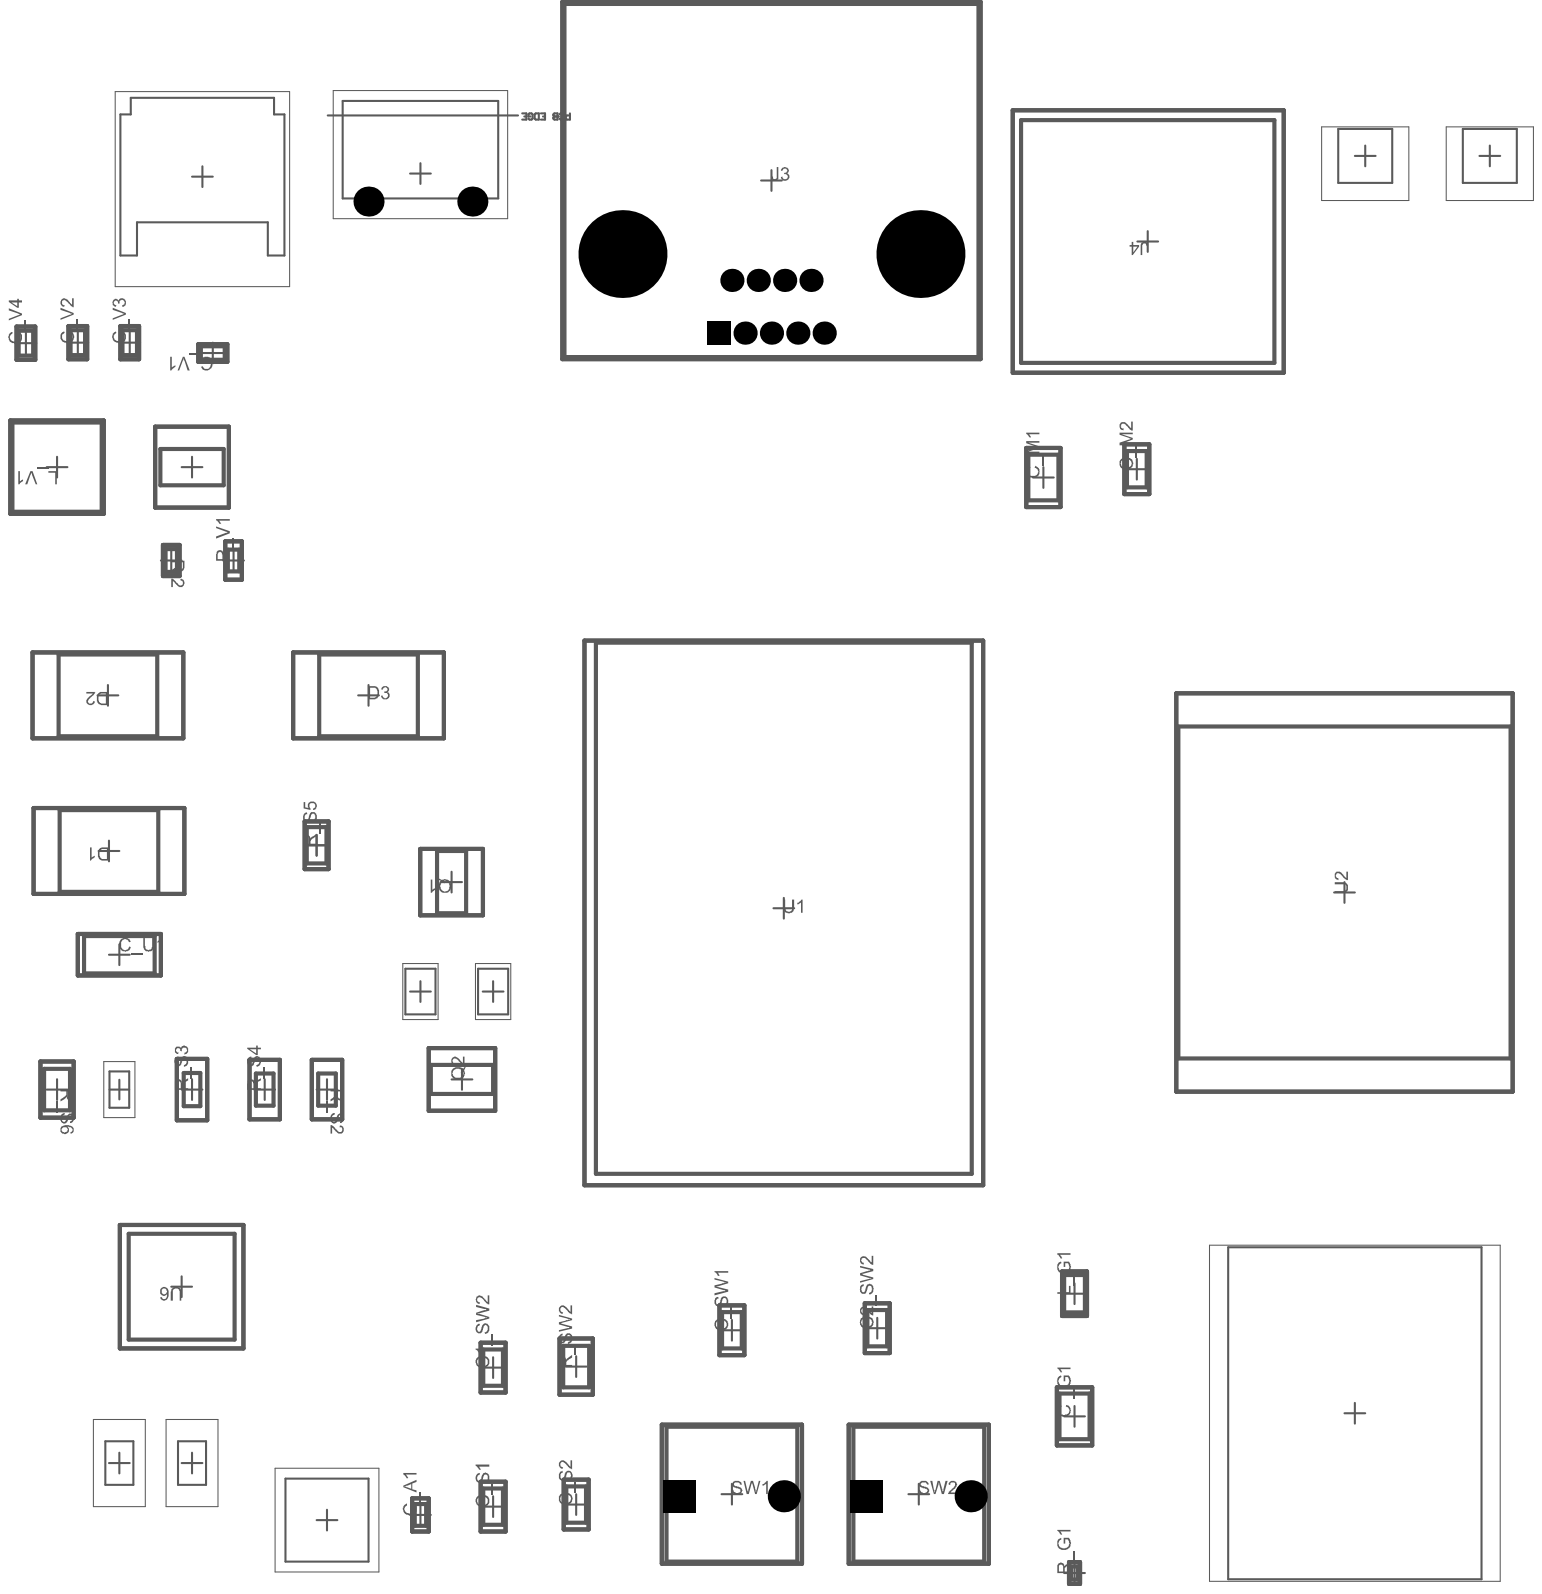
[picture p23: page 4]
