geobenedict/Design-Files/CIRCUIT_DIAGRAM/PCB_FILES/PAYLOAD_ELECTRIC_COMPONENT/DW_PEC_DESING_RULE_VERIFICATION_REPORT.PDF

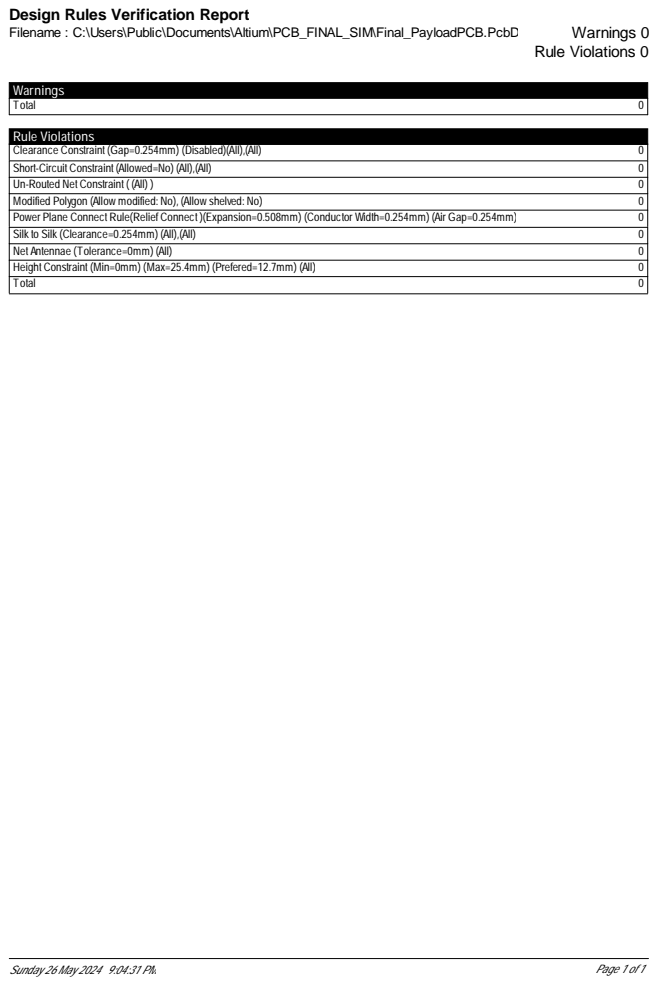
[picture p24: page 1]

Design Rules Verification Report
