geobenedict/Design-Files/CIRCUIT_DIAGRAM/PCB_FILES/PAYLOAD_ELECTRIC_COMPONENT/DW_PEC_DRILL_DRAWINGS.PDF

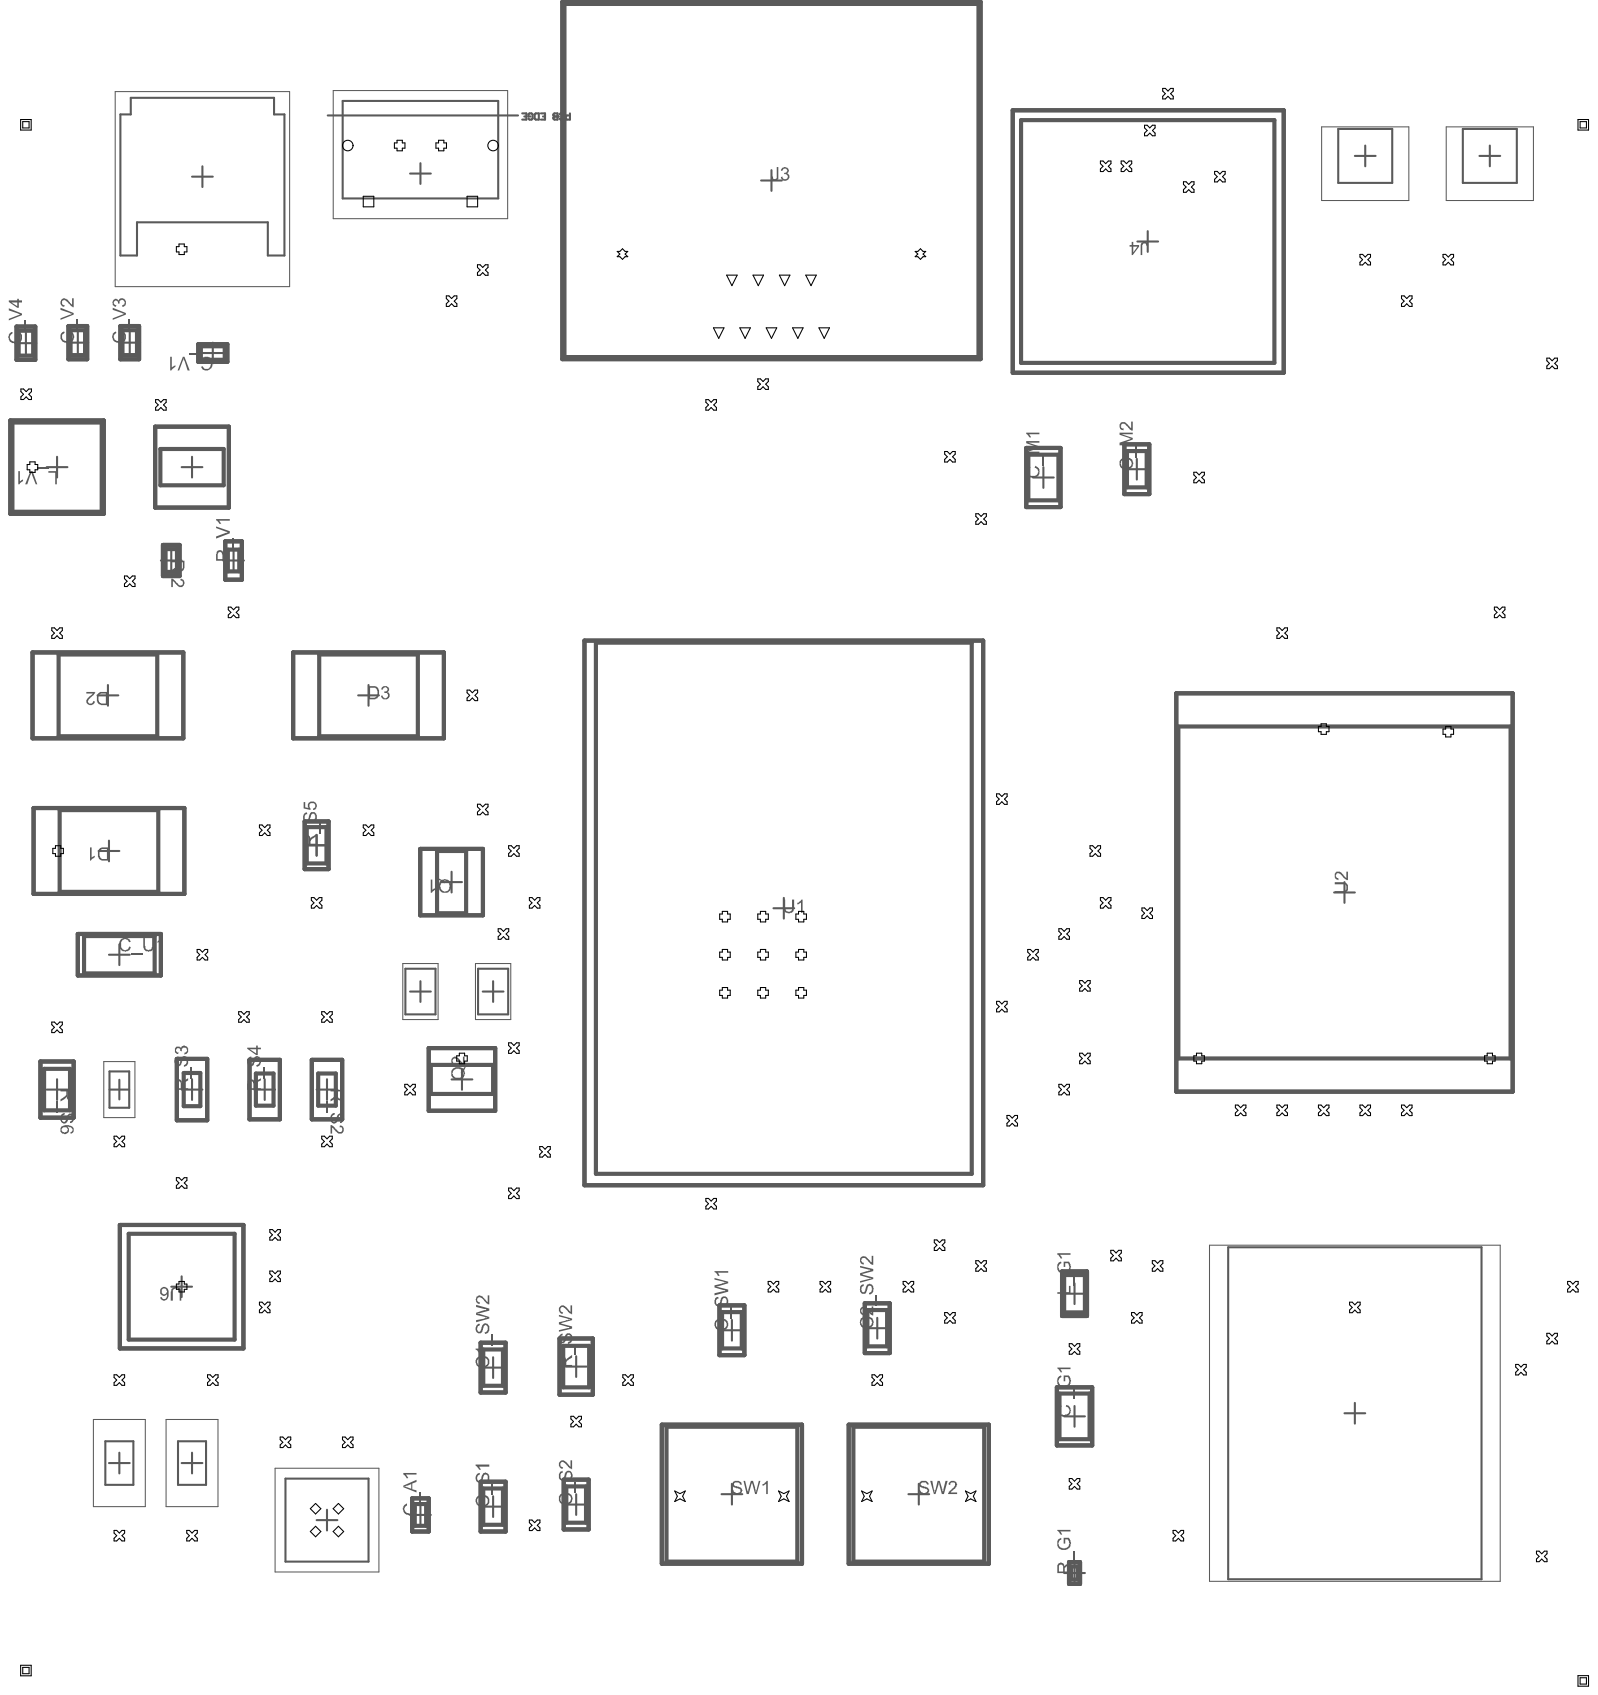
[picture p25: page 1]

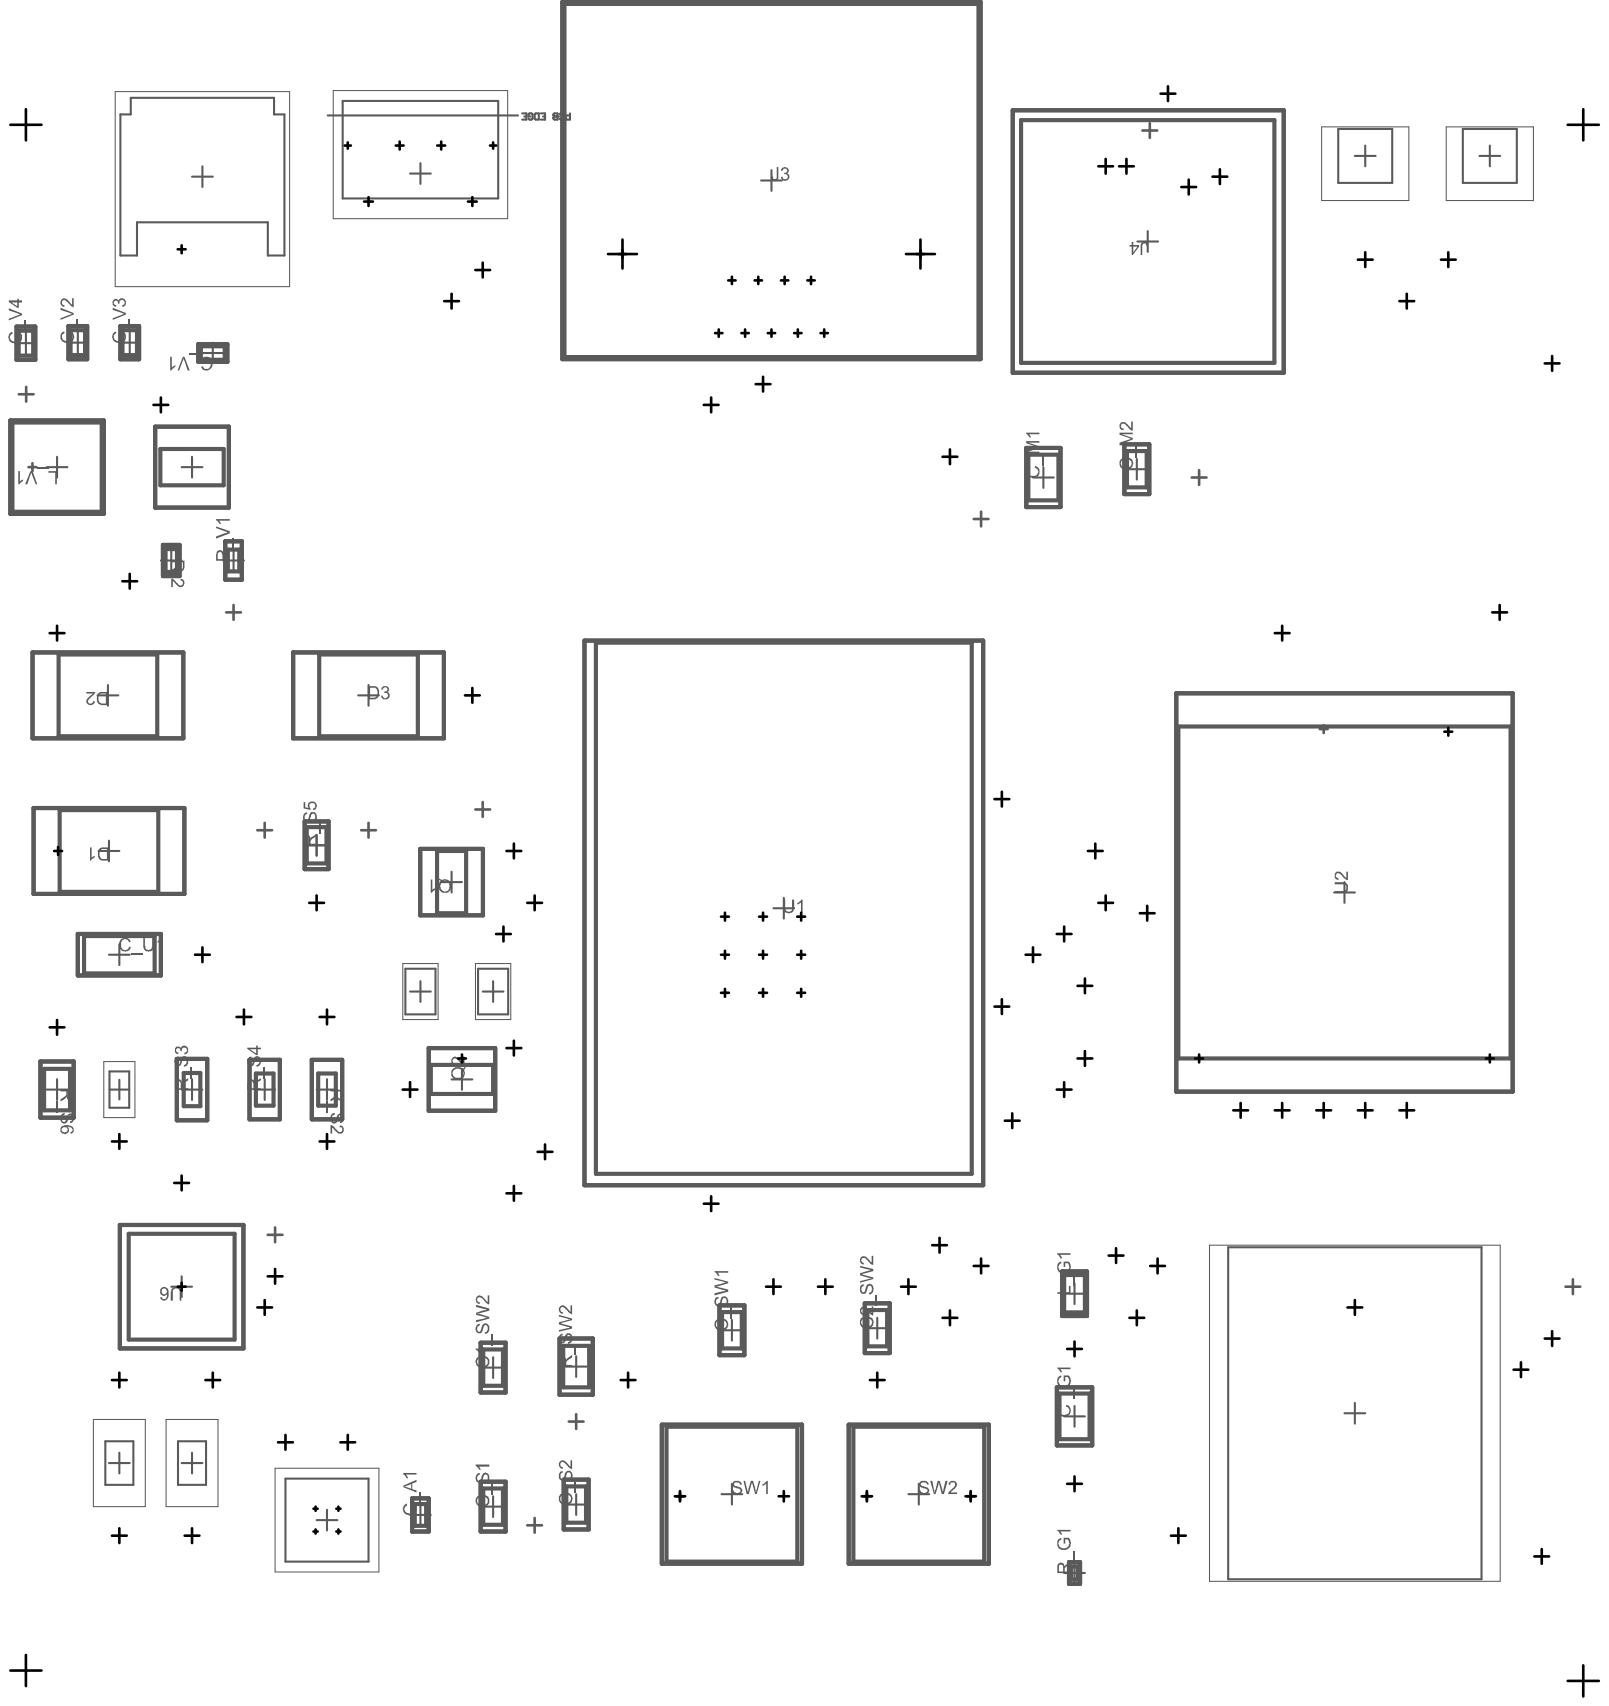
[picture p26: page 2]
