geobenedict/Design-Files/CIRCUIT_DIAGRAM/PCB_FILES/PAYLOAD_ELECTRIC_COMPONENT/DW_PEC_SCHEMATIC PRINTS.PDF

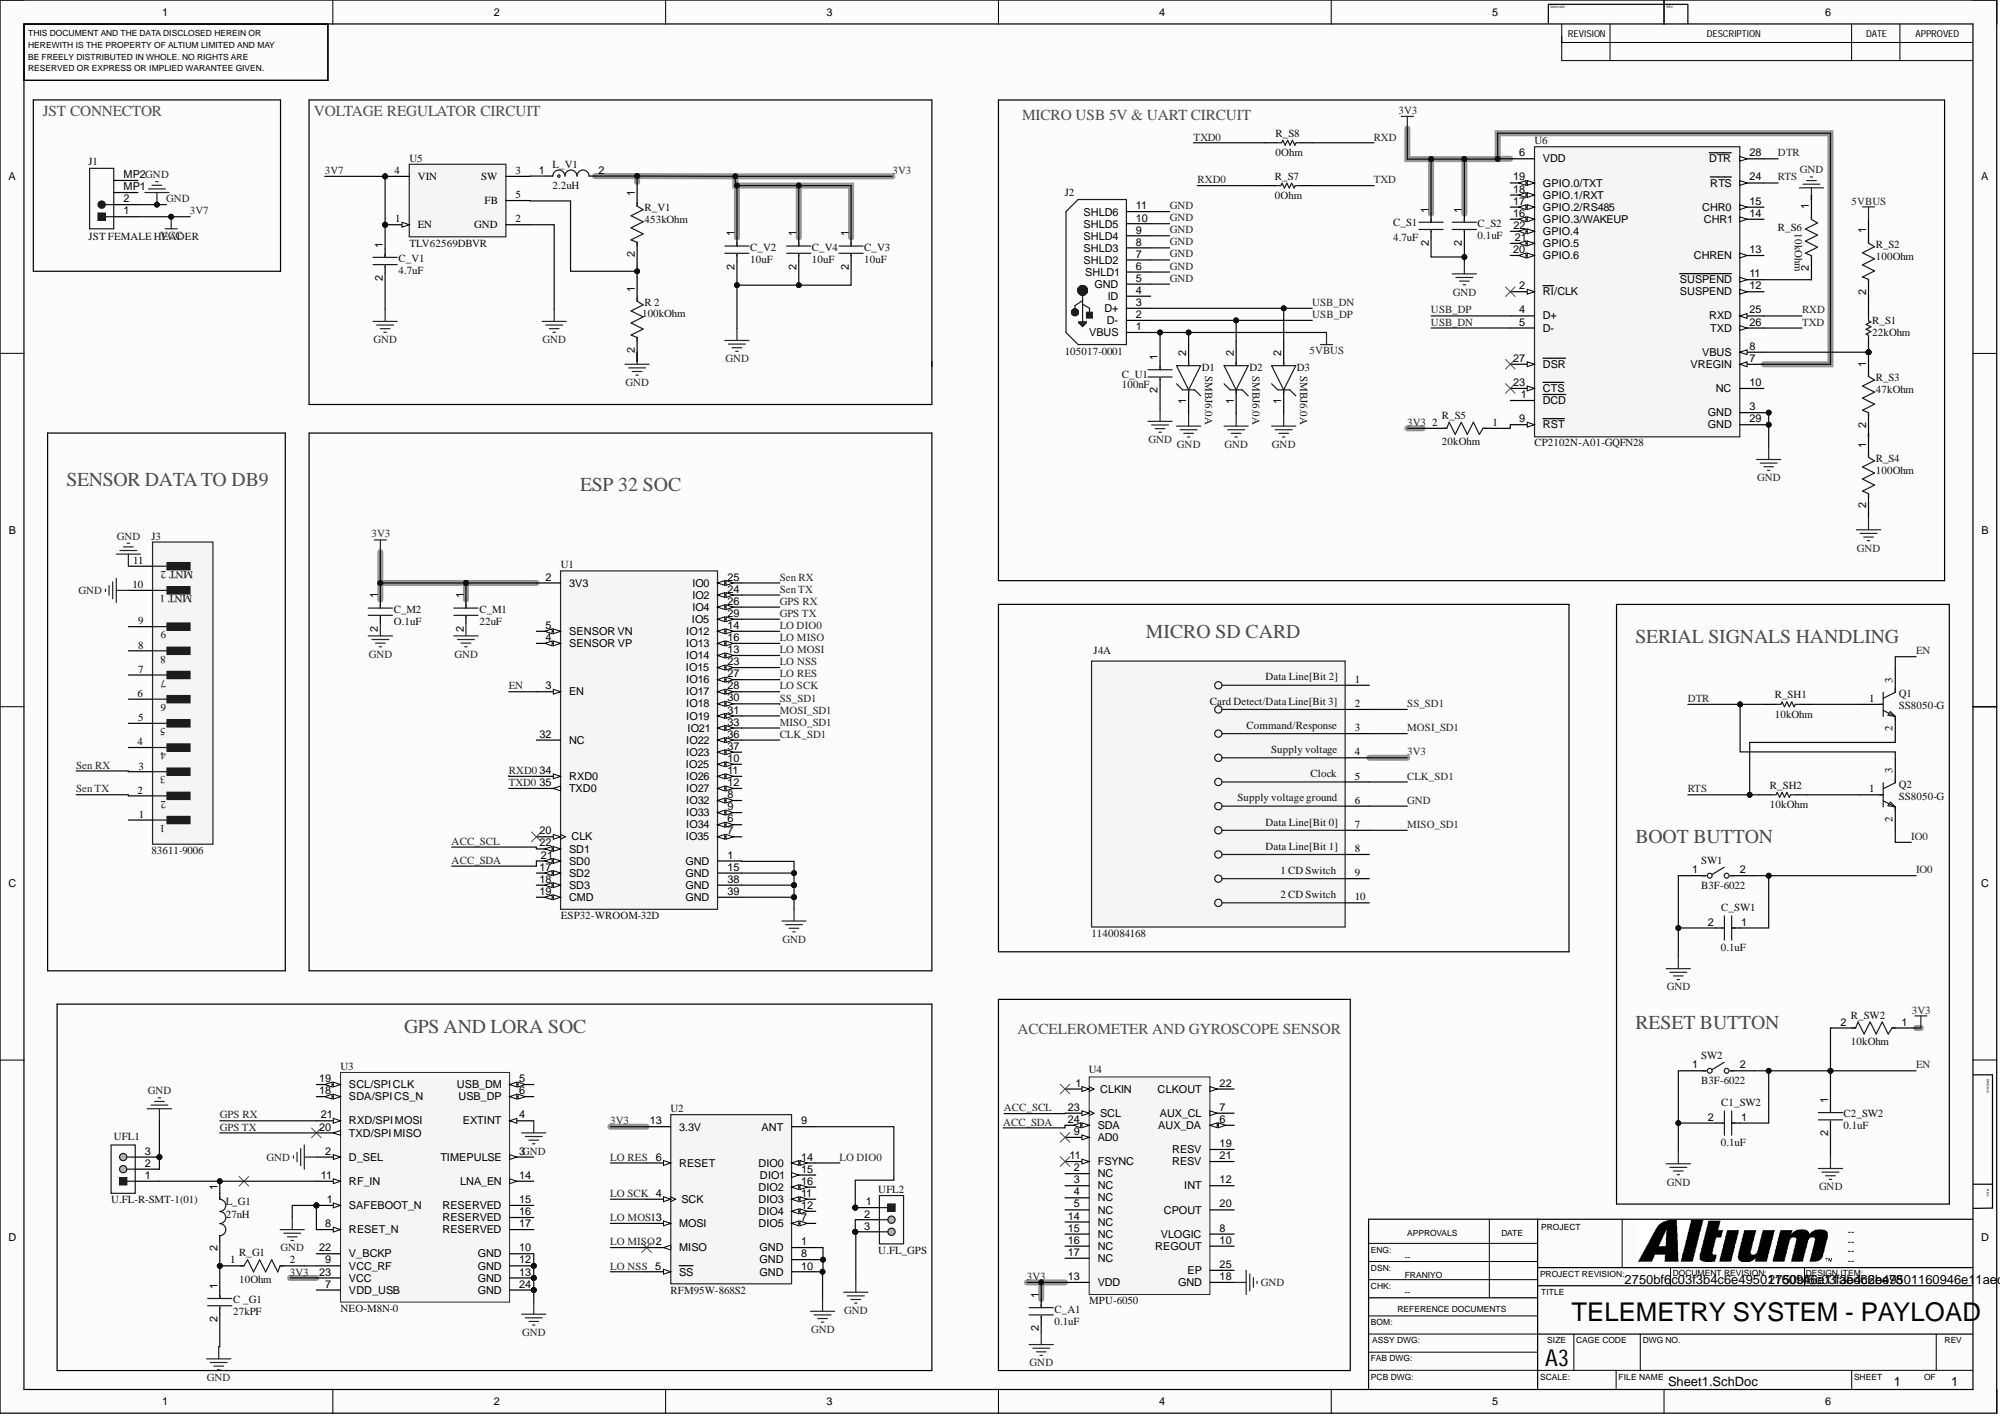
[picture p28: page 1]

THIS DOCUMENT AND THE DA TA DISCL OSED HEREIN O R HEREWITH IS THE PROPERTY OF ALTIUM LIMITED AND M AY BE FREELY DISTRIBUTED IN WHO LE. NO RIGHTS ARE RESERVED OR EXPRESS OR IMPLIED WARANTEE GIVEN. | | REVISI ON | DESCRIPTI O N | DATE | APPROVED

GPS RX GPS TX LO DIO0 LO MISO LO MOSI LO NSS LO RES LO SCK

GPS AND LORA SOC

GPS RX GPS TX
