geobenedict/Design-Files/(list of files, drawings)

Other design files:
CIRCUIT_DIAGRAM/PCB_FILES/RADIO_TRIANGULATION_BASE_STATION/DW_RTK_PCB_Schematic_EasyEDA.json
